Ksyear/FIRE-TAG/docs/BATTERY_PULL_TRIGGER.md

# 배터리–LOLIN D32 당김식 전원 연결

확인일: 2026-11-09. 기존 구매 목록의 **DTP652533 3.7 V 500 mAh 배터리**를 유지하는 기준입니다. 실물 제작·구동 시험은 아직 하지 않았습니다.

## 구현 방식

**분리핀을 당겨 빼면 전원이 켜지고, 핀이 빠진 동안 켜진 상태를 유지하는 구조**로 만들 수 있습니다. 전선을 당기는 대신 별도 핀·줄과 스위치 고정물을 사용합니다. 완제품 당김 스위치를 그대로 꽂는 구성은 아닙니다.

레버 마이크로스위치의 COM–NC 접점을 사용합니다.

| 상태 | 기구 동작 | COM–NC | 배터리 전원 |
| --- | --- | --- | --- |
| 핀 삽입 | 핀이 레버를 누른 상태 유지 | 열림 | OFF |
| 핀을 당겨 제거 | 레버가 원위치로 복귀 | 닫힘 | ON 유지 |
| 핀 재삽입 | 레버를 다시 누름 | 열림 | OFF |

이 동작은 회로·기구 구성 제안입니다. 핀 고정력, 당김 힘, 충격에 의한 오작동 여부는 고정물 제작 후 시험해야 합니다.

핀 삽입 OFF·제거 ON 유지의 배터리 트리거 구상

그림은 COM–NC 접점을 이용하는 기구 설명입니다. 실제 제작 사진·완제품 트리거·동작 검증 결과가 아닙니다.

## 구매 목록 — 디바이스마트

가격은 2026-11-09 실제 상품 페이지의 VAT 포함 표시가입니다. 검색 요약의 과거 가격과 다를 수 있으며 주문 시 재확인합니다.

| 부품 | 구매 수량 | 표시가 | 역할·준비기간 |
| --- | --- | --- | --- |
| [OMRON D2F-L-D](https://www.devicemart.co.kr/goods/view?no=8906172) | 1개 | 4,708원 | 레버형 SPDT, 납땜 단자. COM–NC 사용 / 4~5일 |
| [Molex 53047-0210](https://www.devicemart.co.kr/goods/view?no=14557287) | 최소 10개 주문, 실제 사용 1개 | 264원/개, 10개 2,640원 | 배터리의 51021-0200과 결합하는 1.25 mm 2핀 헤더 / 해외 1주일 |
| [NW3-CCA-160](https://www.devicemart.co.kr/goods/view?no=1327035) | 1개 | 198원 | D32 쪽 PH 대응 2.0 mm 2핀 케이블, 20 cm |
| [수축튜브 2파이 검정 1 m](https://www.devicemart.co.kr/goods/view?no=12772) | 1개 | 154원 | 납땜 접합부 개별 절연 |

위 전기 부품 표시가 합계 **7,700원**, 배송비·핀·줄·고정물 제작비 별도입니다. Molex 부품은 케이블이 없는 기판용 헤더이므로 배선 납땜과 흔들리지 않는 고정이 필요합니다.

추가 제작물: 스위치 고정 케이스, 레버를 눌러 유지하는 분리핀, 손잡이 줄, 전선 당김 방지 구조. 치수와 당김 힘을 확정하지 않아 특정 핀·줄 상품을 호환 확정품으로 지정하지 않았습니다.

이전에 안내한 [ada-4720 케이블 세트](https://www.devicemart.co.kr/goods/view?no=15530981)는 이번 확인에서 품절로 표시됐습니다. 이번 목록은 그 부품 대신 53047-0210 헤더를 사용하는 안입니다.

## 스위치·분리핀 확대 구상

스위치 트리거 구상도: 핀 삽입 OFF, 당겨 빼면 ON 유지

이 그림은 레버 작동 원리를 설명합니다. 실제 제품 단자 위치나 고정물 제작 치수를 뜻하지 않습니다.

## 전기 연결

```text
배터리 + → Molex 헤더 → 스위치 COM
스위치 NC → PH 2.0 케이블 + → D32 BAT+
배터리 − → PH 2.0 케이블 − → D32 GND
스위치 NO는 연결하지 않음
```

단자 위치를 모양·선 색만으로 정하지 않고 스위치 도면·기판 표기와 멀티미터로 확인합니다. 스위치를 배터리 양단에 병렬로 연결하면 단락되므로 위와 같이 +선에 직렬로 넣습니다. 배터리 선 자체를 자를 필요는 없습니다.

## 확인한 사양과 남은 시험

- LOLIN D32 공식 사양: 3.7 V Li-Po, PH-2 2.0 mm 배터리 단자, 최대 충전 전류 500 mA. [WEMOS 사양](https://docs.wemos.cc/en/latest/d32/d32.html)
- D2F-L-D는 D2F 일반 작동력 계열의 레버·납땜 단자형입니다. 제조사 표의 해당 계열 DC 저항 부하 정격은 **30 VDC, 2 A**입니다. `D2F-F` 저작동력형이나 `D2F-01` 미소부하형과 정격을 혼동하지 않습니다. [OMRON D2F 데이터시트](https://omronfs.omron.com/en_US/ecb/products/pdf/en-d2f.pdf)
- D2F 일반형의 최소 적용 부하는 제조사 표에서 5 VDC·100 mA의 참고값으로 제시됩니다. 배터리 전압에서 실제 Tag 부하·접점 저항·전압 강하·반복 동작을 확인해야 합니다. 이번 검토는 실물 연결 성공이나 장기 신뢰성을 보증하지 않습니다.
- 배터리 51021 계열과 53047 계열의 결합 관계: [Molex 규격](https://www.molex.com/content/dam/molex/molex-dot-com/products/automated/en-us/productspecificationpdf/510/51021/510211010-PS-000.pdf)
- 해당 배터리의 허용 충전 전류·보호회로는 추가 확인이 필요합니다. 충전 호환성이 확인되기 전에는 D32에 연결한 채 USB 충전을 진행하지 않습니다.
- USB가 꽂혀 있으면 스위치를 OFF해도 D32가 USB 전원으로 계속 동작할 수 있습니다. 배터리 트리거 시험은 USB를 분리한 상태에서 확인합니다.

제작 후 확인 순서: 배터리 분리 상태에서 COM–NC 도통 확인 → 극성 확인 → USB 분리 → 핀 삽입 OFF·제거 ON 확인 → 실제 UWB 측정 중 전압 강하·재부팅 여부 확인 → 반복 당김·당김 방지 구조 확인.
