Ksyear/FIRE-TAG/docs/images/스위치_트리거_생성기록.md

# 스위치 트리거 확대 구상도 생성 기록

- 생성 방식: 내장 image_gen 이미지 편집
- 기준 이미지: 당김식_배터리트리거_구상.png
- 출력 이미지: 스위치_트리거_구상도.png
- 목적: 배터리·보드 전체 배선보다 분리핀과 레버 스위치의 작동 구조를 크게 설명.
- 동작: 핀 삽입으로 레버를 누르면 COM–NC가 열려 OFF, 핀 제거로 레버가 복귀하면 COM–NC가 닫혀 ON 유지.
- 설명용 기구 구상이며 실물 동작·고정력·내구성·정확한 단자 위치는 검증하지 않았습니다.

## 최종 생성 프롬프트

Edit the referenced image into a NEW, MUCH MORE FOCUSED switch-trigger concept drawing. The user explicitly wants the SWITCH AND PULL-PIN MECHANISM, not another system overview or document link. Keep the clean navy Korean presentation style, but REMOVE the large battery and LOLIN board pictures and enlarge the switch assembly to dominate the image. One 16:9 landscape canvas, two clear side-by-side CLOSE-UP cutaway views of the SAME proposed trigger housing.

Title exactly: '스위치 트리거 구상도'.

LEFT: heading '① 핀 삽입 · OFF'. Show a small rigid protective housing containing a lever microswitch, with an electrically insulating white plastic pin inserted from above through a guide. A yellow pull ring is attached to the pin. The inserted pin mechanically holds the silver switch lever DOWN. Label the three visible mechanical parts with concise callouts: '분리핀', '레버', '마이크로스위치'. A small readable text under the view says '레버 눌림 → COM–NC 열림 → 전원 OFF'.

RIGHT: heading '② 당겨 빼기 · ON 유지'. Show exactly the same housing and switch, but with the pin pulled completely upward and out, a bold upward arrow next to the ring labelled '당김'. The spring-loaded lever has returned UP, so COM–NC is closed. Under this view text exactly '레버 복귀 → COM–NC 연결 → 전원 ON'. A short second line says '핀이 빠진 동안 ON 유지'.

For each switch show only two SYMBOLIC external terminal labels COM and NC, with red positive wire entering COM from the left and leaving NC to the right. Labels at the far wire ends may read '배터리 +' and 'LOLIN BAT+'; do not draw whole battery or board. Do not draw a wire that directly bypasses the COM–NC switch, and never connect positive to negative. This is a mechanical microswitch actuated by a removable pin, not a pin used as a bare electrical conductor or a shim inside a battery socket. The normal unpressed NC contact is closed; pressing the lever opens NC.

Use sparse clean technical illustration, white background, charcoal and navy labels, yellow ring, neutral gray housing, red positive lead. All Korean text must be large and legible. No dimensions, no exact commercial switch body or terminal-position claims, no relay, no MOSFET, no charger, no LED, no fire or explosive imagery. Small footer exactly '설명용 기구 구상 · 실물 동작 미검증'. This is a proposal for a pull-to-power-on mechanism, not a validated or manufactured product.
