Ksyear/FIRE-TAG/docs/images/당김식_배터리트리거_생성기록.md

# 당김식 배터리 트리거 이미지 생성 기록

- 방식: 내장 image_gen 생성 기능
- 이미지: 당김식_배터리트리거_구상.png
- 의미: 핀이 레버를 누르면 COM–NC 개방·OFF, 핀을 빼면 레버 복귀·COM–NC 연결·ON 유지.
- 범위: 배터리 +선에 스위치를 직렬로 넣는 제작 구상입니다. 실물 동작·접점 저항·당김 힘·내구성은 미검증입니다.
- 보드·소켓·기구 외형과 배선 위치는 설명용이며 실제 부품 조립 도면이 아닙니다.
- 근거: ../BATTERY_PULL_TRIGGER.md의 제조사 사양·배선 검토·디바이스마트 부품 목록.

## 최종 생성 프롬프트

Use case: scientific-educational. Generate ONE simple clean 16:9 landscape Korean illustration explaining a proposed pull-pin battery power trigger for a LOLIN D32 ESP32 prototype. White background, clear navy typography, friendly restrained product-diagram style consistent with an educational electronics presentation. Title exactly '당김식 배터리 전원 트리거 구상'. Two side-by-side panels showing THE SAME components in THE SAME arrangement. On the left of each panel a small flat silver/blue Li-Po pouch battery labelled '3.7V 배터리'. In the middle a small trigger housing with a CUTAWAY showing a lever microswitch and a removable NONCONDUCTIVE pin, the pin attached to a yellow pull ring or fabric pull tab. On the right a generic LOLIN D32 board labelled 'LOLIN D32'. A two-wire battery cable passes through this assembly to the board; red positive is switched, black negative runs directly and continuously to the board. All connector/socket depictions are symbolic, not assembly pin-position drawings.
LEFT PANEL title exactly '핀 삽입 · OFF'. Show pin inserted, mechanically HOLDING THE MICROSWITCH LEVER PRESSED DOWN. The COM–NC circuit is OPEN in this pressed condition, so the board is shown muted and a large neutral 'OFF' label. It is NOT a pin directly separating battery metal contacts.
RIGHT PANEL title exactly '핀 제거 · ON 유지'. Show the pin and yellow pull ring pulled completely out to the side, with a clear outward pull arrow labelled '당김'. The switch lever is now RELEASED, its COM–NC contact is CLOSED, battery power reaches the board, and the board is full color with a green 'ON' text label. The ON state persists while the pin remains absent; do not depict a button that must be held. Do not draw a glowing board LED or imply specific firmware behavior.
One short central caption exactly '배터리 +선에 스위치를 직렬 연결'. One small callout exactly '레버 스위치 COM–NC 사용'. Footer clearly reads '추가 제작 구상 · 실물 동작 미검증' and 'USB를 분리한 배터리 전원 기준'.
Keep schematic current paths physically sensible and NEVER bridge battery positive and negative. Do not add chargers, boost converters, relay modules, MOSFET boards, live flame, explosives, grenades, firefighter certification, human subjects, exact pin-number wiring, measured dimensions or charging claims. The intent is a readily understandable mechanical pull-trigger concept, not a finished commercial trigger or a photo of an assembled prototype.
