Ksyear/FIRE-TAG/발표자료/11/16/발표대본.md

# 11월 16일 발표 대본

- 범위: UWB·ESP32 통신 확인 이후 Pi 수신·좌표 저장·경량 UI까지
- 구성: 본편 10장 + 질문 대응용 부록 5장
- 시간: 본편 370초(6분 10초) 추정 + 전환·호흡 여유 50초 = 7분 기준. 실제 발화 리허설 전.
- 각 슬라이드의 동일 대본을 PPT 발표자 노트에도 저장
- [PPTX](FIRE-TAG_11월16일_발표자료_배터리추가.pptx) · [발표 흐름](발표흐름.md)

## 1. Pi 수신부터 경량 화면까지 연결 · 예상 30초

- 화면에서 짚을 곳: 지난 발표와 이번 발표의 범위 비교

지난 발표에서는 **UWB(유더블유비, 초광대역 무선)** 모듈을 **ESP32(이에스피삼십이)**에 연결하고 통신을 확인했습니다.
이번에는 앵커가 측정한 값을 **Raspberry Pi(라즈베리파이)**로 전달했습니다. Pi에 저장한 좌표를 경량 웹 화면에서 확인하는 단계까지 구성했습니다.
전체 연결 구조를 설명한 뒤 실제 코드와 동작 영상을 보여드리겠습니다.
(쉼)

- 근거: 경량버전/11월16일_발표자료.md, 1~4절

## 2. 실내 장치 구성 · 예상 35초

- 화면에서 짚을 곳: 아래 Tag, 양옆 앵커, 위쪽 A0와 Pi 순서

먼저 전체 장치 구성입니다.
이동하는 장치는 **Tag(태그)** 한 대입니다. 고정 장치는 **A0(에이제로)**, **A1(에이원)**, **A2(에이투)** 세 대입니다.
Tag와 앵커가 거리를 측정합니다. A0가 각 앵커의 보고를 모아 Pi로 전달합니다.
그림은 연결 관계를 설명하기 위한 예시입니다. 실제 위치 계산에는 시험 전에 교정한 앵커 좌표를 사용했습니다.
(쉼)

- 근거: firmware/fire_tag_tag/fire_tag_tag.ino:1, firmware/fire_tag_anchor/fire_tag_anchor.ino:1

## 3. Pi와 A0 연결 · 예상 30초

- 화면에서 짚을 곳: Pi와 A0 사이의 하늘색 USB 케이블

이제 중앙의 유선 연결부터 보겠습니다.
Pi의 **USB(유에스비)** 포트와 A0 ESP32를 케이블로 연결했습니다. 이때 A0가 **USB 시리얼(시리얼 통신)**로 측정 보고를 보냅니다.
A1과 A2의 보고도 A0를 거쳐 이 연결로 들어옵니다. 그래서 Pi에서는 A0에 연결된 시리얼 포트를 읽도록 구성했습니다.
다음은 거리값을 얻는 과정입니다.
(쉼)

- 근거: firmware/fire_tag_anchor/fire_tag_anchor.ino:3, raspberrypi/fire_tag_receiver.py:246

## 4. Tag와 앵커 거리 측정 · 예상 35초

- 화면에서 짚을 곳: Tag와 세 앵커 사이의 양방향 UWB 화살표

유선 연결에 앞서, 거리값은 여기서 만들어집니다.
Tag가 앵커에 요청을 보냅니다. 앵커가 응답하면 Tag가 마지막 메시지를 보냅니다.
그림의 **POLL(폴)**, **RESP(알이에스피)**, **FINAL(파이널)** 순서입니다. 앵커는 이 교환에서 얻은 시간 정보로 거리를 계산합니다.
Tag가 세 앵커와 이 과정을 반복합니다. 각 앵커까지의 거리값을 모아 다음 단계로 전달합니다.
(쉼)

- 근거: firmware/fire_tag_tag/fire_tag_tag.ino:3, firmware/fire_tag_anchor/fire_tag_anchor.ino:3

## 5. A1·A2 보고를 A0로 전달 · 예상 35초

- 화면에서 짚을 곳: A1·A2에서 A0로 들어오는 점선 화살표

측정한 거리값은 A0에 모읍니다.
A1과 A2는 **ESP-NOW(이에스피나우)**로 A0에 측정 보고를 보냅니다. A0는 자신의 측정값도 함께 모읍니다.
여기서 UWB는 거리 측정에 쓰고, ESP-NOW는 앵커 사이의 보고 전달에 씁니다.
Pi가 ESP-NOW 보고를 직접 받는 구조는 아닙니다. Pi에는 A0가 USB로 전달합니다.
(쉼)

- 근거: firmware/fire_tag_anchor/fire_tag_anchor.ino:3~7

## 6. Pi에서 위치 계산·화면 표시 · 예상 35초

- 화면에서 짚을 곳: USB 보고 방향과 하단 처리 순서

A0가 보낸 보고를 Pi에서 처리합니다.
수신기는 교정된 앵커 좌표와 Tag 거리값으로 평면 위치를 계산합니다. 계산한 좌표는 **SQLite(에스큐엘라이트)** 데이터베이스에 저장합니다.
경량 웹 서버는 저장된 값을 읽어서 화면에 제공합니다. 같은 **Wi-Fi(와이파이)**의 Mac이나 휴대폰에서 Pi에 접속합니다.
다음 화면에서는 이 처리 중 계산과 저장 부분을 실제 코드로 보겠습니다.
(쉼)

- 근거: raspberrypi/fire_tag_receiver.py:443, raspberrypi/fire_tag_web_lite.py:1

## 7. 거리값을 좌표로 계산해 저장 · 예상 45초

- 화면에서 짚을 곳: solve_position 호출, 실패 시 return, self.store.position 호출

앞에서 설명한 계산과 저장을 담당하는 코드입니다.
먼저 위쪽의 **solve_position(솔브 포지션)**을 보시면, 앵커 좌표와 거리값을 넣어 위치를 구합니다. 계산할 수 없으면 여기서 처리를 멈춥니다.
계산이 끝나면 **x, y(엑스, 와이)** 좌표를 얻습니다. 아래의 **store.position(스토어 포지션)**이 결과를 데이터베이스에 저장합니다.
그 전에 세 앵커의 거리 수집과 교정 완료를 검사합니다. 화면에는 핵심 부분만 발췌했습니다.
(쉼)

- 근거: raspberrypi/fire_tag_receiver.py:443~476, Store.position:114~119

## 8. 경량 화면에 저장 좌표를 표시 · 예상 35초

- 화면에서 짚을 곳: Tag 위치 점, 앵커 상태, 최근 이벤트

이어서 실제 Pi에서 제공한 경량 화면입니다.
제공받은 ZIP의 경량 UI 원본을 적용했습니다. 화면에서는 Tag의 마지막 저장 위치를 점으로 보여줍니다.
오른쪽에서는 앵커 상태와 최근 이벤트 **10개**를 확인합니다. 새 좌표가 들어오면 위치 점이 갱신됩니다.
이번 발표는 이 경량 화면까지입니다. 이어서 실제 접속 영상을 보여드리겠습니다.
(쉼)

- 근거: raspberrypi/web/index_lite.html:129, raspberrypi/fire_tag_web_lite.py:21, 이미지 저장/08_Pi_경량UI_실제화면.png

## 9. 실제 Pi에서 좌표 갱신을 확인 · 예상 55초

- 화면에서 짚을 곳: 영상 재생 후 Tag 점의 갱신

실제 Pi에 접속해 녹화한 영상입니다.
위치 점이 갱신되는 모습을 보시겠습니다.

[영상 **41.56초** 재생. 재생 중에는 설명을 멈춥니다.]

(쉼)

- 근거: 경량버전/Pi_경량UI_실제접속시험.mp4, 경량버전/11월16일_발표자료.md:4~5절

## 10. 통신·저장·화면 갱신을 확인 · 예상 35초

- 화면에서 짚을 곳: 이번 확인 결과와 남은 시험

여기까지 이번에 확인한 결과입니다.
세 앵커의 거리값을 Pi로 전달하고, 계산한 좌표를 저장해 경량 화면에서 갱신하는 흐름을 확인했습니다.
시험할 때마다 앵커 번호와 고정 배치, 앵커 세 쌍의 거리를 확인해야 합니다. 앵커를 옮기면 다시 교정합니다.
실제 기준 위치와 비교한 오차나 사람에게 가려지는 조건은 추가 시험이 필요합니다. 화재 현장 신뢰성도 아직 검증하지 않았습니다.
(쉼)

- 근거: 경량버전/11월16일_발표자료.md:4~5절

## 11. 시험 시작마다 앵커를 다시 교정 (선택 부록) · 예상 40초

- 화면에서 짚을 곳: config.update의 교정 플래그와 세 쌍 거리 표

앵커 배치가 바뀌는 경우의 처리입니다.
실행 스크립트가 시작할 때마다 자동 교정 플래그를 켭니다. A0·A1·A2의 세 쌍 거리를 모아 좌표를 다시 정하도록 했습니다.
마지막 시험에서는 세 쌍의 교정을 완료했습니다. 실행 도중 앵커를 옮기면 다시 시작해 재교정해야 합니다.
(쉼)

- 근거: raspberrypi/run_dev.sh:28~37, raspberrypi/anchor_pair_calibration.py:37~67, 경량버전/11월16일_발표자료.md:5절

## 12. 배터리 전원 연결 구상 (선택 부록) · 예상 40초

- 화면에서 짚을 곳: 배터리 양극의 직렬 스위치와 음극 직결 경로

이제 다음 제작 단계인 배터리 연결 계획입니다.
기존 선정 배터리는 **3.7V, 500mAh** 제품입니다. 배터리의 플러스 선에 스위치를 직렬로 넣고, 마이너스 선은 보드의 배터리 단자에 연결할 계획입니다.
분리핀을 당기면 전원이 켜지는 구조로 구상했습니다. 배터리 커넥터가 보드와 달라 변환 케이블도 제작해야 합니다.
현재는 연결 구상이며 실물 제작과 구동 시험 전입니다.
(쉼)

- 근거: 트리거_구상/BATTERY_PULL_TRIGGER.md; https://www.devicemart.co.kr/goods/view?no=15337888; https://docs.wemos.cc/en/latest/d32/d32.html

## 13. 커넥터 변환 케이블을 제작할 계획 (선택 부록) · 예상 50초

- 화면에서 짚을 곳: 1.25mm와 2.0mm 규격 차이, 네 가지 준비 부품

커넥터가 달라 그대로 꽂을 수는 없습니다.
기존 배터리는 **Molex(몰렉스) 51021-0200, 1.25mm** 커넥터이고, **LOLIN D32(로린 디삼십이)**는 **PH-2, 2.0mm** 배터리 단자입니다.
배터리 쪽에는 대응 헤더를 쓰고, 보드 쪽에는 PH 케이블을 연결할 계획입니다. 스위치와 절연 재료도 준비합니다.
표의 부품은 제작 후보입니다. 케이블 외형·극성을 확인하고, 스위치는 실제 배터리 부하에서 접점 동작을 시험한 뒤 확정하겠습니다.
(쉼)

- 근거: https://docs.wemos.cc/en/latest/d32/d32.html; https://www.devicemart.co.kr/goods/view?no=15337888; https://www.molex.com/content/dam/molex/molex-dot-com/products/automated/en-us/productspecificationpdf/510/51021/510211010-PS-000.pdf; https://omronfs.omron.com/en_US/ecb/products/pdf/en-d2f.pdf; 트리거_구상/BATTERY_PULL_TRIGGER.md. NW3-CCA-160은 A2001-02Y 하네스이며 제조사별 외형 변경 안내가 있어 D32 결합 확인 전에는 호환 확정품으로 표시하지 않음.

## 14. 당김식 전원 스위치 구상 (선택 부록) · 예상 30초

- 화면에서 짚을 곳: 핀 삽입 OFF, 핀 제거 ON 유지

분리핀의 동작은 이 그림과 같습니다.
절연핀이 레버를 누를 때는 **COM–NC(콤, 엔씨)** 접점이 열려 전원이 꺼집니다. 핀을 빼면 레버가 복귀하고 접점이 연결돼 켜진 상태를 유지합니다.
전선을 당기지 않고 별도 핀과 고정물을 당기는 방식으로 제작할 계획입니다.
실물 동작은 아직 검증하지 않았습니다.
(쉼)

- 근거: 트리거_구상/BATTERY_PULL_TRIGGER.md; https://omronfs.omron.com/en_US/ecb/products/pdf/en-d2f.pdf

## 15. 제작 후 전원 동작을 확인 (선택 부록) · 예상 45초

- 화면에서 짚을 곳: 분리 상태 검사, USB 분리 전원 시험, UWB 동작 시험

제작 후에는 이 순서로 확인하겠습니다.
먼저 배터리를 분리한 상태에서 극성과 스위치 도통을 확인합니다. 다음으로 USB를 빼고 핀 삽입과 제거에 따라 전원이 꺼지고 켜지는지 확인합니다.
이후 실제 UWB 동작 중 전압 강하나 재부팅, 반복 당김 시 접점 이상을 시험할 계획입니다.
배터리의 허용 충전 전류와 보호회로도 먼저 확인해야 합니다. 사용 시간은 소비전류를 측정한 뒤 산정하겠습니다.
(쉼)

- 근거: https://docs.wemos.cc/en/latest/d32/d32.html; https://omronfs.omron.com/en_US/ecb/products/pdf/en-d2f.pdf; 트리거_구상/BATTERY_PULL_TRIGGER.md. 아직 배터리 허용 충전 전류·보호회로·실제 부하 전류·동작 시간 미확인.
