Ksyear/FIRE-TAG/발표자료/11/16/경량버전/11월16일_발표자료.md

# 11월 16일 발표 자료 — FIRE-TAG 경량 UI

작성·시험일: 2026-11-09. 이번 발표는 ESP32·UWB 통신 확인 이후 **Raspberry Pi 수신과 경량 UI 구성까지** 다룹니다.

## 1. 지난 발표와 이번 발표

| 구분 | 발표 내용 |
| --- | --- |
| 지난 발표 | UWB 모듈을 ESP32에 연결하고 통신되는지 확인 |
| 이번 발표 | 앵커 데이터를 Pi로 전달하고, 앵커 상태·저장 좌표·최근 이벤트를 경량 웹 화면에 표시 |

이번 자료에는 기존 전체 UI의 동선·경보·명령 버튼이나 층별 확장 계획을 발표 기능으로 포함하지 않습니다.

## 2. 사용 장치와 데이터 흐름

- 요구조자 Tag: LOLIN D32 + DWM3000EVB, 1개
- 고정 앵커: ESP32 DevKitC + DWM3000EVB, 3개
- 수신·저장·웹 표시: Raspberry Pi

```text
Tag ↔ 앵커 A0·A1·A2             UWB 거리 측정
A1·A2 → A0                    ESP-NOW 데이터 전달
A0 → Raspberry Pi             USB 시리얼
Pi 수신기 → SQLite → 웹 화면   데이터 저장·표시
휴대폰·Mac → Pi                같은 Wi-Fi에서 HTTP 접속
```

단계별 발표에는 [4단계 설명 이미지와 발표 문장](단계별_설명자료.md)을 사용합니다.

### 실내 구성 설명 이미지

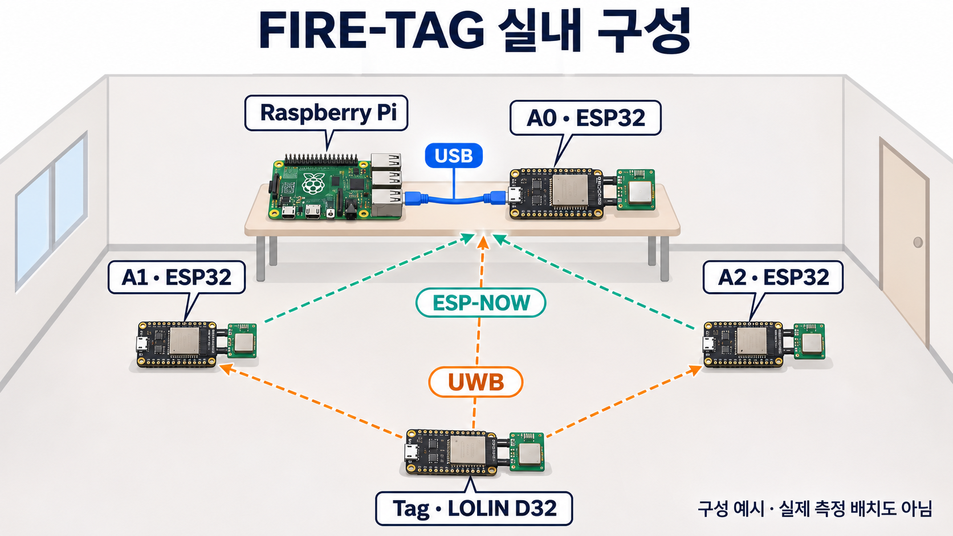
[picture p3: 발표자료/11/16/경량버전/images/실내_구성도.png]
중앙 Pi·A0와 양옆 A1·A2 구성


중앙의 라즈베리파이는 A0 ESP32와 USB로 연결합니다. 양옆 A1·A2 ESP32는 A0로 ESP-NOW 보고를 보내고, Tag와 세 앵커는 UWB로 거리를 측정합니다.

그림은 배치를 이해하기 위한 생성 이미지입니다. 실제 교실 사진이나 실측 배치도가 아니며, 마지막 시험에서 측정한 거리와 교정 결과는 아래 5절을 기준으로 설명합니다.

## 3. 경량 화면에 남긴 기능

- 평면도에 앵커 위치와 Tag의 마지막 저장 좌표 표시
- Tag 좌표가 갱신되면 점 위치 갱신, 동선은 표시하지 않음
- 앵커 상태: 작동 중 / 수신 기록 없음 / 응답 없음
- 최근 이벤트 10개
- Tag 데이터가 오래되면 `끊김`, 웹 API 접속이 실패하면 `Pi 연결 끊김` 표시
- 외부 CDN·인터넷 자료를 가져오지 않는 화면

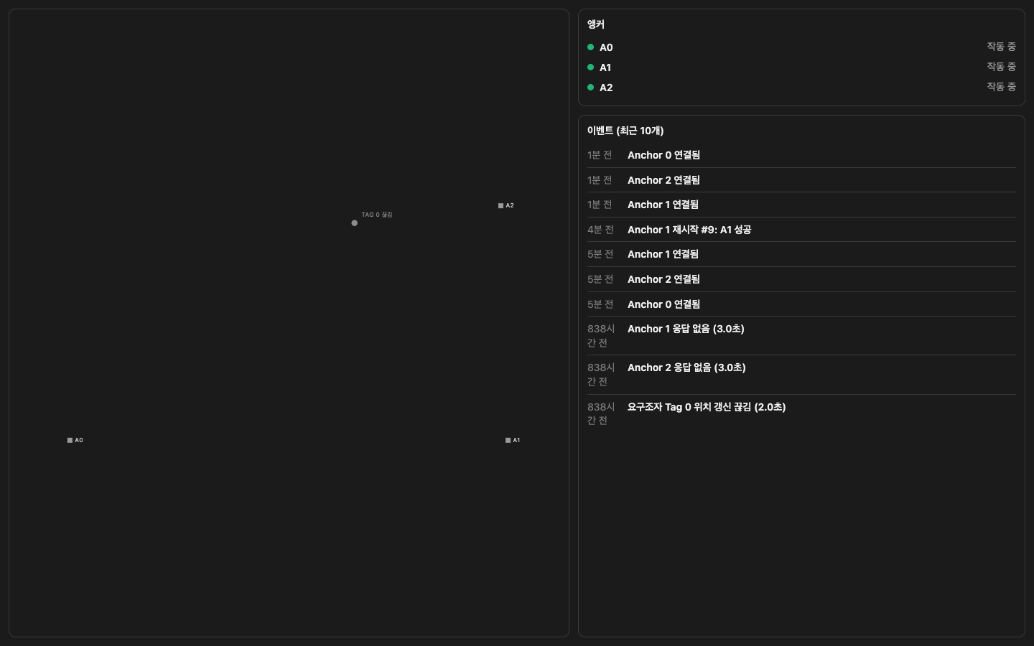
[picture p4: 발표자료/11/16/경량버전/Pi_경량UI_실제화면.png]
Pi에서 실제 제공한 경량 화면


화면은 ZIP 원본 서버·HTML을 그대로 사용해 실제 Pi에 접속한 캡처입니다. 앵커 세 쌍의 교정을 완료한 뒤 Tag의 새 좌표가 갱신되는 상태를 녹화했습니다.

## 4. 이번 시험에서 확인한 내용

| 시험 | 확인 결과 |
| --- | --- |
| Tag ↔ 앵커 | Tag 재시작 후 A0·A1·A2 거리 응답 로그 확인 |
| 앵커 → Pi | A0 재시작 후 세 앵커의 새 상태 데이터 수신 확인 |
| Pi 웹 서버 | Mac에서 HTML과 API 접속 확인 |
| 실제 화면 녹화 | 41.56초 녹화, API 응답 74회 모두 HTTP 200, 브라우저 스크립트 오류 0건, 서로 다른 좌표 71개 확인 |
| 경량 UI 기능 시험 | 별도 시험 DB로 점 이동·오래된 Tag 표시·이벤트 10개·연결 실패와 복구 확인 |
| 기존 코드 회귀 시험 | Python 자동 시험 15개 통과 |
| Wi-Fi 설정 | Mobile_504 유지, Hanbat_506 추가 등록. Hanbat_506 실제 접속 시험은 보류 |

UI 기능 시험의 좌표는 시험용 데이터입니다. 실제 UWB 측정 영상과 혼동하지 않습니다.

## 5. 앵커 재배치와 실제 위치 갱신

초기 배치에서는 A0–A1 직접 거리 보고가 없어 좌표 교정이 완료되지 않았습니다. 사용자가 가림막과 A1 배치를 확인한 뒤 측정을 새로 시작해 세 쌍의 교정이 완료됐습니다. 배치 확인 전후 관측 결과이며 특정 가림막만을 원인으로 확정한 것은 아닙니다.

| 측정 쌍 | 새 교정 거리 |
| --- | --- |
| A0–A1 | 6.89 m |
| A0–A2 | 6.57 m |
| A1–A2 | 3.47 m |

교정에 사용한 샘플은 89개이고, 표시된 반복 측정 산포는 약 8 cm입니다. 이 산포는 실제 위치 오차가 아닙니다. 교정 후 Tag의 새 좌표가 갱신되는 화면을 실제 Pi에서 녹화했습니다.

시험 실행 스크립트는 시작할 때마다 세 앵커의 상호 거리를 다시 확인하도록 수정했습니다. A1·A2의 배치가 바뀌어도 이전 좌표를 그대로 사용하지 않습니다. 실행 중 앵커를 옮긴 경우에는 다시 시작해 재교정해야 합니다.

실제 기준 위치와 비교한 정확도, 화재 현장 신뢰성은 이번 시험에서 검증하지 않았습니다.

## 6. 시연 자료와 접속

- [실제 Pi 대시보드 접속 시험 영상](Pi_경량UI_실제접속시험.mp4)
- 현재 경량 화면: `http://192.168.68.102:8080/`
- 네트워크를 바꾸면 Pi에서 `hostname -I`로 새 주소 확인
- 발표 전 매번 앵커 번호·고정 배치·세 쌍의 상호 거리를 확인하고 교정 완료 여부 확인

ZIP의 서버와 HTML을 수정 없이 사용합니다. 기존 화면은 별도 파일과 8081 포트로 보존했습니다. 이번 발표는 8080 포트의 경량 화면을 사용합니다.

## 발표 설명 예시

지난 발표에서는 UWB 모듈과 ESP32를 연결해 통신되는지 확인했습니다. 이번에는 앵커에서 받은 데이터를 Raspberry Pi에 저장하고 웹 화면으로 보여주는 단계까지 진행했습니다. 화면은 위치 점, 앵커 상태, 최근 이벤트만 남긴 경량 버전입니다. 시험 전에는 앵커 세 쌍의 거리를 직접 측정해 좌표를 새로 설정했고, 실제 Pi 화면에서 Tag 위치가 갱신되는 모습을 녹화했습니다. 앵커를 옮기면 다시 교정해야 합니다. 현재 확인한 결과는 실내 시제품의 통신·저장·위치 표시 동작이며 실제 위치 정확도까지 검증한 것은 아닙니다.
