Ksyear/FIRE-TAG/발표자료/11/16/경량버전/images/생성_기록.md

# 실내 구성도 생성 기록

- 생성 방식: 내장 image_gen 기능. CLI/API 키 방식은 사용하지 않았습니다.
- 파일: `실내_구성도.png`
- 구성: 중앙 Raspberry Pi+A0, 양옆 A1·A2, 앞쪽 Tag.
- 통신: Pi–A0 USB, A1·A2→A0 ESP-NOW, Tag↔앵커 UWB.
- 표현 범위: 설명용 실내 예시입니다. 교실 사진·실측 배치도·정확한 부품 외형이나 핀 배치 도면이 아닙니다.
- 근거: 프로젝트 README, `firmware/libraries/FireTagUwb/src/FireTagUwb.h`, 2026-11-09 실기 검증 기록.

## 최종 생성 프롬프트

Use case: infographic-diagram. Generate ONE simple, clean, landscape 16:9 educational illustration for a Korean FIRE-TAG university presentation. The user wants a quick understandable indoor arrangement, not a detailed engineering schematic. A plain classroom-like indoor room, lightly suggested neutral walls and floor, viewed from a clear slightly elevated isometric perspective. At the BACK CENTER of the room, on a small plain table, place a recognizable Raspberry Pi 4 and next to it an ESP32 DevKitC with a separate small UWB module. Label the Pi 'Raspberry Pi' and the ESP32 'A0 · ESP32'. Connect the Pi and A0 with ONE clearly visible short BLUE USB cable, label it 'USB'. A0 is the central gateway. On the LEFT SIDE of the room place a second ESP32 with a small UWB module, label 'A1 · ESP32'. On the RIGHT SIDE place a third ESP32 with a small UWB module, label 'A2 · ESP32'. A1 and A2 are a little forward of the central A0 so the three anchors form a visible triangle. Do NOT connect side boards to the Pi with wires. Draw a simple dashed teal wireless arrow from A1 toward A0 and another from A2 toward A0. A single common label says 'ESP-NOW'. In the foreground place one SMALL separate portable board icon labelled 'Tag · LOLIN D32' with a UWB module; draw three light orange dashed radio links to A0, A1 and A2, collectively labelled 'UWB'. Keep all radio lines thin and visually clear, no decorative waves. No people, flames, firefighters, clouds, routers, LoRa, battery circuits, distances, coordinate axes, pin tables, extra devices or screens. Title at the top exactly 'FIRE-TAG 실내 구성'. Large comfortably legible text, white or very light gray background, tidy spacing, subdued navy and teal colors, simple recognizable board illustrations. Small footer exactly '구성 예시 · 실제 측정 배치도 아님'. The central Pi connects ONLY to A0 through USB. A1/A2 report to A0 through ESP-NOW, while Tag ranges with the three anchors through UWB. Do not draw ESP32-to-router Wi-Fi connections. This is an explanatory generated illustration, not a photo of the actual test room.
