Ksyear/FIRE-TAG/발표자료/11/16/경량버전/images/단계별/생성_기록.md

# 단계별 이미지 생성 기록

- 방식: 내장 image_gen 편집 기능
- 기준 이미지: ../실내_구성도.png
- 네 장 모두 같은 구성 이미지에서 설명 경로만 강조했습니다.
- 설명용 이미지이며 실제 교실 사진·실측 배치도·부품 조립 도면이 아닙니다.

## 01_Pi_A0_USB_연결

Edit Image 1, the existing FIRE-TAG indoor diagram. This is an edit target, not just a style reference. Create ONE 16:9 landscape educational slide image for a four-step Korean presentation. Preserve the exact viewpoint, neutral room, table, board illustrations, board sizes and positions: Raspberry Pi back-center-left on table, A0 ESP32 immediately right of Pi on table, A1 on left side floor, A2 on right side floor, Tag at front center. Preserve readable device labels and the small footer '구성 예시 · 실제 측정 배치도 아님'. Use the same navy typography, orange UWB, teal ESP-NOW and blue USB as the base. Change ONLY the title and emphasis/communication arrows described for this step. Do not add people, devices, flame, batteries, routers, cloud, distance labels, a fake UI screenshot or new network technologies. No Wi-Fi radio links directly from ESP32 to Pi. Keep non-highlighted devices present in muted gray so the four images form a stable visual sequence. Make only the current step visually active and remove unrelated radio arrows, rather than showing every protocol in all four images. All text must be large and comfortably readable. STEP 1. Title exactly '1. Pi와 A0 연결'. Highlight the Raspberry Pi, the A0 ESP32 and their short blue USB cable at full color. Cable must plug into both existing boards. Keep side anchors and Tag muted but labelled. Remove ALL orange and teal radio arrows and their UWB/ESP-NOW badges. Add one short readable caption in empty center-floor space: 'Pi ↔ A0 · USB 시리얼'. Do not draw a direct GPIO connection or a cable from Pi to A1, A2 or Tag.

## 02_Tag_UWB_거리측정

Edit Image 1, the existing FIRE-TAG indoor diagram. This is an edit target, not just a style reference. Create ONE 16:9 landscape educational slide image for a four-step Korean presentation. Preserve the exact viewpoint, neutral room, table, board illustrations, board sizes and positions: Raspberry Pi back-center-left on table, A0 ESP32 immediately right of Pi on table, A1 on left side floor, A2 on right side floor, Tag at front center. Preserve readable device labels and the small footer '구성 예시 · 실제 측정 배치도 아님'. Use the same navy typography, orange UWB, teal ESP-NOW and blue USB as the base. Change ONLY the title and emphasis/communication arrows described for this step. Do not add people, devices, flame, batteries, routers, cloud, distance labels, a fake UI screenshot or new network technologies. No Wi-Fi radio links directly from ESP32 to Pi. Keep non-highlighted devices present in muted gray so the four images form a stable visual sequence. Make only the current step visually active and remove unrelated radio arrows, rather than showing every protocol in all four images. All text must be large and comfortably readable. STEP 2. Title exactly '2. Tag와 앵커 거리 측정'. Highlight Tag and all three anchors A0/A1/A2 at full color, and keep Pi and the USB cable muted. Draw THREE clear bidirectional orange radio arrows between Tag and A0, between Tag and A1, and between Tag and A2. Ensure each orange line terminates at the corresponding anchor board, especially A0 on the right side of the central table, never at the Raspberry Pi or at the USB cable. Remove ALL teal ESP-NOW arrows and labels. Use one orange 'UWB' badge and a concise explanatory caption 'POLL → RESP → FINAL'. This is two-way ranging; both ends of each orange link need arrowheads.

## 03_ESP_NOW_A0_보고전달

Edit Image 1, the existing FIRE-TAG indoor diagram. This is an edit target, not just a style reference. Create ONE 16:9 landscape educational slide image for a four-step Korean presentation. Preserve the exact viewpoint, neutral room, table, board illustrations, board sizes and positions: Raspberry Pi back-center-left on table, A0 ESP32 immediately right of Pi on table, A1 on left side floor, A2 on right side floor, Tag at front center. Preserve readable device labels and the small footer '구성 예시 · 실제 측정 배치도 아님'. Use the same navy typography, orange UWB, teal ESP-NOW and blue USB as the base. Change ONLY the title and emphasis/communication arrows described for this step. Do not add people, devices, flame, batteries, routers, cloud, distance labels, a fake UI screenshot or new network technologies. No Wi-Fi radio links directly from ESP32 to Pi. Keep non-highlighted devices present in muted gray so the four images form a stable visual sequence. Make only the current step visually active and remove unrelated radio arrows, rather than showing every protocol in all four images. All text must be large and comfortably readable. STEP 3. Title exactly '3. A1·A2 보고를 A0로 전달'. Highlight A1, A2 and A0, keep Pi and Tag muted. Draw TWO clear teal dashed arrows, one FROM A1 TO A0 and one FROM A2 TO A0. They must terminate precisely at the A0 ESP32 board immediately right of the Raspberry Pi, NOT at the Pi, not at the USB cable, and not in empty space under the table. Label the arrows 'ESP-NOW'. Remove ALL orange UWB arrows and badges. Keep the physical USB cable present but muted. Add short caption in empty floor area 'A0는 자신의 측정값도 함께 모음'. Do not draw wireless arrows between Pi and side anchors.

## 04_Pi_위치계산_화면표시

Edit Image 1, the existing FIRE-TAG indoor diagram. This is an edit target, not just a style reference. Create ONE 16:9 landscape educational slide image for a four-step Korean presentation. Preserve the exact viewpoint, neutral room, table, board illustrations, board sizes and positions: Raspberry Pi back-center-left on table, A0 ESP32 immediately right of Pi on table, A1 on left side floor, A2 on right side floor, Tag at front center. Preserve readable device labels and the small footer '구성 예시 · 실제 측정 배치도 아님'. Use the same navy typography, orange UWB, teal ESP-NOW and blue USB as the base. Change ONLY the title and emphasis/communication arrows described for this step. Do not add people, devices, flame, batteries, routers, cloud, distance labels, a fake UI screenshot or new network technologies. No Wi-Fi radio links directly from ESP32 to Pi. Keep non-highlighted devices present in muted gray so the four images form a stable visual sequence. Make only the current step visually active and remove unrelated radio arrows, rather than showing every protocol in all four images. All text must be large and comfortably readable. STEP 4. Title exactly '4. Pi에서 위치 계산·화면 표시'. Highlight A0 and Raspberry Pi and their blue USB cable. Add a clear small blue directional arrow above the cable FROM A0 on right TOWARD Pi on left, showing reports going to Pi. Keep A1, A2 and Tag muted with unchanged positions and labels. Remove ALL orange and teal radio arrows/badges. In empty center floor area, show ONE simple large horizontal text process: '수신 → 위치 계산 → SQLite 저장 → 경량 UI'. Below it add 'Mac·휴대폰에서 같은 Wi-Fi로 접속'. Do not draw an invented dashboard, browser screen, laptop, router, cloud or any extra hardware. This image introduces the real screenshot and real video shown separately in the next slides.
