Ksyear/FIRE-TAG/발표자료/11/16/README.md

# 11월 16일 발표 자료

이번 발표 범위는 **경량 UI 버전까지**입니다.

- [완성 PPTX · 본편 10장과 선택 부록 2장](FIRE-TAG_11월16일_발표자료.pptx)
- [PDF 백업본](FIRE-TAG_11월16일_발표자료.pdf)
- [슬라이드별 발표 대본](발표대본.md)
- [발표 흐름·시간·코드 설명·질문 대응](발표흐름.md)

- [경량 버전 발표 자료](경량버전/11월16일_발표자료.md)
- [실제 Pi 접속 시험 영상](경량버전/Pi_경량UI_실제접속시험.mp4)
- [실제 화면 캡처](이미지%20저장/08_Pi_경량UI_실제화면.png)

- [손그림 버전 이미지 폴더·목록](이미지%20저장/_이미지_목록.md)
- [손그림 변경 전 원래 버전 이미지 7장](이미지%20저장/원래버전/_이미지_목록.md)
- [실내 구성 이미지](이미지%20저장/01_실내_전체구성.png)
- [단계별 설명 이미지 4장과 발표 문장](경량버전/단계별_설명자료.md)
- [PPT 이미지·영상 삽입안](경량버전/PPT_이미지_삽입안.md)

- [스위치 트리거 구상도](이미지%20저장/07_스위치_트리거_구상도.png)
- [배터리 트리거 구상·구매 목록](트리거_구상/BATTERY_PULL_TRIGGER.md)

이미지는 모두 `이미지 저장/` 아래에 모았습니다. 현재 생성 이미지 7장은 아이보리 배경·검은 손글씨와 펜 선·하늘색 한 계열로 통일했고, 변경 전 원래 이미지 7장은 `원래버전/` 하위 폴더에 별도 보관했습니다. 실제 UI 캡처 1장은 원본을 유지하며 두 버전에서 공통으로 사용합니다. [최종 생성 프롬프트](이미지%20저장/이미지생성프롬프트_FIRE-TAG_11월16일.md)도 같은 폴더에 있습니다.

## 코드 버전 구분

| 버전 | 화면 파일 | 접속 경로 |
| --- | --- | --- |
| 경량·다운그레이드 | [index_lite.html](../../../raspberrypi/web/index_lite.html) | `:8080/` |
| 기존 전체 화면 | [index_full.html](../../../raspberrypi/web/index_full.html) | `:8081/` |

ZIP 원본 서버(`fire_tag_web_lite.py`)와 원본 HTML을 그대로 사용합니다. 수신기·SQLite는 두 버전이 공유하고 웹 서버·API는 분리합니다. 전체 화면의 경보·명령·CSV 기능은 기존 API로 유지되며 경량 화면에는 표시하지 않습니다.
