Ksyear/FIRE-TAG/발표자료/11/16/발표흐름.md

# 11월 16일 발표 흐름

- [완성 PPTX](FIRE-TAG_11월16일_발표자료_배터리추가.pptx) · [PDF 백업](FIRE-TAG_11월16일_발표자료_배터리추가.pdf) · [슬라이드별 발표 대본](발표대본.md)
- 본편 10장, 선택 부록 5장. 범위는 Pi 수신·좌표 저장·경량 UI까지.
- 발표 시간 미지정으로 7분 기준 구성. 본편 예상 370초(6분 10초), 나머지 50초는 전환·호흡 여유. 실제 리허설 실측값이 아님.
- 기본 그림은 손그림 버전 사용. [변경 전 이미지 7장](이미지%20저장/원래버전/_이미지_목록.md)은 별도 보관.

## 설명 순서

지난 발표의 통신 확인을 짧게 짚고, 이번에 연결한 Pi 수신·저장·화면 표시를 소개합니다. 전체 구성도를 먼저 보여준 뒤 USB 연결, UWB 거리 측정, ESP-NOW 보고, Pi 처리 순서로 설명합니다. 실제 코드 한 장과 실제 UI를 보여주고 녹화 영상을 재생합니다. 마지막 장에서 확인한 동작과 남은 시험을 구분합니다.

| 장 | 화면 | 누적 시간(추정) | 예상 체류 | 넣은 자료 |
| --- | --- | --- | --- | --- |
| 1 | Pi 수신부터 경량 화면까지 연결 | 0:00~0:30 | 30초 | 지난 발표와 이번 범위 비교 |
| 2 | 실내 장치 구성 | 0:30~1:05 | 35초 | [그림](%EC%9D%B4%EB%AF%B8%EC%A7%80%20%EC%A0%80%EC%9E%A5/01_%EC%8B%A4%EB%82%B4_%EC%A0%84%EC%B2%B4%EA%B5%AC%EC%84%B1.png) |
| 3 | Pi와 A0 연결 | 1:05~1:35 | 30초 | [그림](%EC%9D%B4%EB%AF%B8%EC%A7%80%20%EC%A0%80%EC%9E%A5/02_Pi_A0_USB_%EC%97%B0%EA%B2%B0.png) |
| 4 | Tag와 앵커 거리 측정 | 1:35~2:10 | 35초 | [그림](%EC%9D%B4%EB%AF%B8%EC%A7%80%20%EC%A0%80%EC%9E%A5/03_Tag_UWB_%EA%B1%B0%EB%A6%AC%EC%B8%A1%EC%A0%95.png) |
| 5 | A1·A2 보고를 A0로 전달 | 2:10~2:45 | 35초 | [그림](%EC%9D%B4%EB%AF%B8%EC%A7%80%20%EC%A0%80%EC%9E%A5/04_ESP_NOW_A0_%EB%B3%B4%EA%B3%A0%EC%A0%84%EB%8B%AC.png) |
| 6 | Pi에서 위치 계산·화면 표시 | 2:45~3:20 | 35초 | [그림](%EC%9D%B4%EB%AF%B8%EC%A7%80%20%EC%A0%80%EC%9E%A5/05_Pi_%EC%9C%84%EC%B9%98%EA%B3%84%EC%82%B0_%ED%99%94%EB%A9%B4%ED%91%9C%EC%8B%9C.png) |
| 7 | 거리값을 좌표로 계산해 저장 | 3:20~4:05 | 45초 | 실제 수신기 코드 발췌 |
| 8 | 경량 화면에 저장 좌표를 표시 | 4:05~4:40 | 35초 | [실제 UI 캡처](이미지%20저장/08_Pi_경량UI_실제화면.png) |
| 9 | 실제 Pi에서 좌표 갱신을 확인 | 4:40~5:35 | 55초 | [실제 영상](경량버전/Pi_경량UI_실제접속시험.mp4) |
| 10 | 통신·저장·화면 갱신을 확인 | 5:35~6:10 | 35초 | 확인 결과·다음 시험 |

## 코드 화면을 보여주는 방법

- 본편 7장에 실제 `fire_tag_receiver.py`의 `flush()` 일부만 표시. `solve_position`과 `self.store.position` 두 호출을 중심으로 설명.
- 코드는 편집 가능한 PPT 텍스트. 캡처 이미지로 만들지 않았고, 읽기 쉽게 줄바꿈과 생략 주석만 추가.
- 입력은 교정된 앵커 좌표와 앵커별 거리(m). 출력은 x·y 좌표와 DB의 최근 좌표 갱신.
- 코드 앞의 거리 개수 확인·앵커 교정 완료 검사, 중간 상태 갱신·로그는 발췌 화면에서 생략. 원본 실행 코드의 검사를 삭제한 것이 아님.
- `rms`는 거리 잔차이며 실제 기준 위치에 대한 위치 오차로 발표하지 않음.
- 전체 IDE, 긴 수식 구현, 경량 UI에 없는 명령·경보 코드는 본편에서 설명하지 않음.
- 부록 11장은 `run_dev.sh`의 매 시작 재교정 설정과 마지막 시험의 앵커 거리 표. 재배치 질문에 사용.

## 영상 시연 순서

1. 본편 8장에서 위치 점, 앵커 상태, 최근 이벤트 10개를 먼저 짚습니다.
2. 9장으로 넘겨 영상이 실제 Pi 접속 기록임을 한 문장으로 말합니다.
3. PPT에 포함한 영상을 클릭해 41.56초 재생합니다. 재생 중에는 점이 갱신되는 모습을 보게 둡니다.
4. 영상이 끝나면 잠시 멈추고 10장의 결과로 넘어갑니다.
5. 재생 문제가 있으면 [원본 MP4](경량버전/Pi_경량UI_실제접속시험.mp4)를 별도로 엽니다. PDF는 영상 재생용이 아닌 정지 화면 백업입니다.

실시간 Pi 접속을 필수 시연 경로로 잡지 않았습니다. 하드웨어를 함께 시연할 경우 발표 당일 같은 네트워크에서 Pi 주소와 서버 실행 상태를 확인해야 합니다. 시험 당시 주소를 현재 접속 가능한 주소로 보장하지 않습니다.

## 시험 전 확인할 것

- 매 시험마다 A0·A1·A2 번호, 고정 배치, 세 쌍 상호 거리를 확인합니다.
- A1·A2 위치가 바뀌면 새 배치에서 교정 완료 후 Tag 이동 시험을 시작합니다.
- 실행 중 앵커를 옮겼다면 재시작해 다시 교정합니다.
- 마지막 시험 기록: A0–A1 6.89 m, A0–A2 6.57 m, A1–A2 3.47 m, 교정 샘플 89개.
- 반복 측정 산포 약 8 cm는 실제 위치 정확도 8 cm를 뜻하지 않습니다.

## 선택 부록과 질문 대응

| 질문 | 답할 내용 | 근거·보조 화면 |
| --- | --- | --- |
| 지난 발표에서 무엇이 늘었나요? | 앵커 보고를 Pi에 수신해 좌표를 저장하고 경량 웹 화면에 표시하는 단계까지 연결했습니다. | 본편 1·6·7장 |
| Wi-Fi로 거리를 재나요? | Tag–앵커 거리는 UWB로 측정합니다. A1·A2 보고는 ESP-NOW로 A0에 전달하고, 브라우저의 Pi 웹 접속은 같은 Wi-Fi를 사용합니다. | 본편 2·4·5·6장 |
| 앵커를 옮기거나 A1·A2 배치가 바뀌면요? | 번호·배치와 세 쌍 거리를 다시 확인하고 재교정합니다. 실행 중 이동하면 재시작해야 합니다. | 부록 11장 |
| 화면 점이 실제 이동 경로와 얼마나 맞나요? | 새 저장 좌표의 갱신을 확인했습니다. 실제 기준 위치·경로와 비교한 정량 오차는 이번 시험에서 검증하지 않았습니다. | 본편 9·10장 |
| 경량 UI를 쓰면 위치 튐이 줄어드나요? | UI에 이동 경로선을 표시하지 않는 것과 측정 오차 감소는 별개입니다. 가림·배치 조건과 기준 위치 비교 시험이 필요합니다. | 본편 8·10장 |
| 사람에게 가리거나 화재 환경에서도 되나요? | 해당 조건의 신뢰성 시험은 아직 하지 않았습니다. 이번 실내 동작 확인만으로 사용 적합성을 보장할 수 없습니다. | 본편 10장 |
| 두 Wi-Fi 모두 시험했나요? | Pi에 두 프로필을 등록했습니다. Hanbat_506 실제 접속 시험은 보류 상태입니다. | 경량버전/11월16일_발표자료.md 4절 |
| 배터리 트리거도 만들었나요? | 추가 제작 구상이며 실물 제작·동작 시험 전입니다. 이번 경량 UI 구현 결과에 포함하지 않습니다. | 부록 12~15장 |

## 배터리 계획을 설명할 때

| 장 | 내용 | 예상 시간 |
| --- | --- | --- |
| 12 | 배터리 +선에 스위치를 직렬로 넣는 전체 연결 구상 | 40초 |
| 13 | 1.25 mm 배터리 커넥터와 D32의 PH-2·2.0 mm 차이, 부품 후보 | 50초 |
| 14 | 절연핀 삽입 OFF·제거 ON 유지의 레버 동작 | 30초 |
| 15 | 극성·도통 확인, USB 분리 전원 시험, UWB 동작 중 전압·재부팅 시험 | 45초 |

배터리 부록 네 장의 예상 합계는 165초(2분 45초)입니다. 본편 10장 뒤에 모두 설명하면 기본 분량 외에 이 시간이 추가됩니다. 짧게 소개할 때는 12장만 보여주고 13~15장은 질문 대응용으로 사용합니다. 모든 시간은 추정이며 실제 리허설 전입니다.

배터리 연결·스위치 고정물 제작·사용 시간 측정은 앞으로 할 일로 설명합니다. 충전 조건과 보호회로를 확인하기 전에는 충전 호환성을 확정하지 않습니다. 구체적인 부품 후보와 근거는 [배터리 연결 문서](트리거_구상/BATTERY_PULL_TRIGGER.md)에 있습니다.

## 준비 상태와 발표 당일 확인

- [x] 본편 10장에 대응하는 대본 10블록과 전환 멘트·쉼 표시 작성
- [x] 각 블록 예상 60초 이하. 영상 장표 55초에는 영상 41.56초 포함
- [x] 본편 예상 370초로 7분의 약 88% 구성
- [x] 실제 코드·구성 그림·실제 캡처·실제 영상의 역할 구분
- [x] 확인된 동작과 위치 정확도·가림 조건의 미검증 범위 구분
- [ ] 발표 PC의 글꼴 표시와 영상 재생 확인
- [ ] 타이머를 켜고 실제 발화 시간 측정
- [ ] 실제 리허설 뒤 장표별 시간 조정

현재 파일은 PPTX와 대본·흐름 문서입니다. 질문 대응용 부록 11~15장은 기본 발표 시간에 포함하지 않았습니다.
