Ksyear/FIRE-TAG/발표자료/11/16/경량버전/PPT_이미지_삽입안.md

# 11/16 PPT 이미지·영상 삽입안

발표 범위는 지난 UWB–ESP32 통신 확인 이후 Raspberry Pi 수신·저장과 경량 UI까지입니다. 기존 전체 UI·배터리 트리거·층별 확장을 이번 구현 결과에 넣지 않습니다.

완성 파일은 [PPTX](../FIRE-TAG_11월16일_발표자료_배터리추가.pptx)와 [PDF 백업](../FIRE-TAG_11월16일_발표자료_배터리추가.pdf)입니다. [발표 대본](../발표대본.md)은 발표자 노트에도 포함했고, [발표 흐름](../발표흐름.md)에 예상 시간·코드 설명·질문 대응을 정리했습니다.

## 슬라이드 구성

| 슬라이드 | 넣은 자료 | 설명 |
| --- | --- | --- |
| 1. Pi 수신부터 경량 화면까지 | 지난 발표·이번 발표 비교 | 통신 확인 이후 Pi 수신·저장·경량 UI까지 연결한 범위 |
| 2. 전체 구성 | [실내 구성도](../이미지%20저장/01_실내_전체구성.png) | Tag·앵커·Pi의 역할부터 소개 |
| 3. Pi와 A0 연결 | [USB 연결 그림](../이미지%20저장/02_Pi_A0_USB_연결.png) | Pi와 A0의 USB 시리얼 |
| 4. UWB 거리 측정 | [거리 측정 그림](../이미지%20저장/03_Tag_UWB_거리측정.png) | Tag와 세 앵커의 메시지 교환 |
| 5. A0로 보고 전달 | [ESP-NOW 그림](../이미지%20저장/04_ESP_NOW_A0_보고전달.png) | A1·A2 보고의 수신 지점은 A0 |
| 6. Pi 처리 | [위치 계산·표시 그림](../이미지%20저장/05_Pi_위치계산_화면표시.png) | 수신·위치 계산·SQLite 저장·경량 UI |
| 7. 실제 수신기 코드 | fire_tag_receiver.py flush() 발췌 | solve_position과 self.store.position 중심 |
| 8. 실제 경량 UI | [원본 화면 캡처](../이미지%20저장/08_Pi_경량UI_실제화면.png) | 위치 점·앵커 상태·최근 이벤트 10개 |
| 9. 실제 동작 영상 | [41.56초 MP4](Pi_경량UI_실제접속시험.mp4) | PPT에 실제 영상 파일 포함 |
| 10. 확인 결과·다음 시험 | 확인 동작·남은 시험 | 교정·새 좌표 갱신 확인, 기준 위치 오차·가림 조건 미검증 |
| 선택 부록 11. 매 시작 재교정 | run_dev.sh 코드·교정 거리 표 | 앵커 번호·배치·세 쌍 거리 매번 확인 |
| 선택 부록 12. 배터리 연결 | [전체 배터리 연결도](../이미지%20저장/06_당김식_배터리트리거_구상.png) | 배터리 +선 직렬 스위치, 실물 구동 전 |
| 선택 부록 13. 커넥터 변환 | 규격 차이·준비 부품 표 | 배터리 1.25 mm와 D32 PH-2·2.0 mm, 후보품은 호환 확인 후 선정 |
| 선택 부록 14. 전원 스위치 | [전원 스위치 확대도](../이미지%20저장/07_스위치_트리거_구상도.png) | 핀 삽입 OFF·제거 ON 유지 |
| 선택 부록 15. 제작 후 시험 | 검사 순서 | 극성·도통, USB 분리 전원 시험, UWB 구동 시험·충전 조건 확인 |

각 이미지의 발표 문장은 [단계별 설명 자료](단계별_설명자료.md)를 사용합니다. 네 장을 같은 크기·같은 위치로 배치하고 화면 전환은 단순 전환으로 맞춥니다. 생성 이미지는 아이보리 배경·검은 손글씨와 펜 선·하늘색 강조를 공통으로 사용하며, 모든 PNG는 [이미지 저장 폴더](../이미지%20저장/_이미지_목록.md)에 모았습니다.

## 구성도에서 설명할 순서

1. **중앙 Pi와 A0**: Pi의 USB 3.0 포트와 A0 ESP32를 USB 케이블로 연결합니다. Pi GPIO에 UWB를 직접 연결한 구조가 아닙니다.
2. **양옆 A1·A2**: ESP32+DWM3000EVB 앵커가 측정 보고를 ESP-NOW로 A0에 전달합니다.
3. **Tag와 세 앵커**: UWB로 거리를 측정합니다. 공유기 Wi-Fi로 Tag의 거리를 재는 방식이 아닙니다.
4. **Pi 내부 처리**: A0의 USB 시리얼을 읽어 위치를 계산하고 SQLite에 저장한 뒤 웹 화면에 표시합니다.
5. **화면 접속**: 같은 Wi-Fi의 Mac·휴대폰에서 Pi에 HTTP로 접속합니다.

그림 아래 넣을 짧은 설명:

> UWB로 거리 측정 → ESP-NOW로 A0에 보고 → USB로 Pi에 전달 → 경량 화면에 표시

## 그림의 사용 범위

- 구성도는 사용자가 요청한 단순한 실내 배치 예시입니다. 실제 교실 사진이나 실측 좌표 도면으로 소개하지 않습니다.
- A1·A2는 실제 배치가 달라질 수 있습니다. 마지막 시험의 교정 거리는 A0–A1 6.894 m, A0–A2 6.569 m, A1–A2 3.471 m입니다.
- 시험마다 앵커 번호·배치·상호 거리를 확인하고, 이동 후에는 다시 교정합니다.
- 교정의 반복 측정 산포 약 8 cm를 위치 정확도 8 cm라고 발표하지 않습니다.
- 프레젠테이션에서 실제 UI와 실제 영상은 원본 파일을 사용합니다. 그림 생성으로 시험 결과를 대신하지 않습니다.

## PPT 편집 시 확인

- 16:9 슬라이드에 그림 전체가 보이도록 삽입하고 비율을 잠급니다. 그림의 선이나 라벨이 잘리도록 채우기 자르기를 하지 않습니다.
- 생성 이미지에 제목이 있으므로 같은 제목을 슬라이드에 중복해서 넣지 않습니다.
- 영상은 `삽입 → 비디오 → 파일에서` 방식으로 넣고, 발표할 PC에서 오프라인 재생을 확인합니다.
- 본편은 10장, 선택 부록은 5장입니다. 본편 예상 6분 10초에 전환 여유 50초를 더한 7분 기준이며 실제 리허설은 아직 하지 않았습니다. 배터리 부록 12~15장을 모두 설명할 경우 예상 2분 45초가 추가됩니다.
