Ksyear/FIRE-TAG/발표자료/11/16/FIRE-TAG_11월16일_발표자료.pptx

FIRE-TAG

Pi 수신부터 경량 화면까지

지난 발표

UWB 모듈과 ESP32 통신 확인

앵커 보고 수신, 좌표 저장, 경량 UI

이번 발표

11월 16일 발표 · 시험 기록 2026.11.09

FIRE-TAG · 11/16

01 / 12

Notes: 슬라이드 1: Pi 수신부터 경량 화면까지 연결
본편. 예상 30초 (추정, 리허설 전)

[발표 대본]
지난 발표에서는 UWB(유더블유비, 초광대역 무선) 모듈을 ESP32(이에스피삼십이)에 연결하고 통신을 확인했습니다.
이번에는 앵커가 측정한 값을 Raspberry Pi(라즈베리파이)로 전달했습니다. Pi에 저장한 좌표를 경량 웹 화면에서 확인하는 단계까지 구성했습니다.
전체 연결 구조를 설명한 뒤 실제 코드와 동작 영상을 보여드리겠습니다.
(쉼)

[가리킬 곳]
지난 발표와 이번 발표의 범위 비교

[화면 핵심어]
UWB·ESP32 통신 확인 / Pi 수신·좌표 저장·경량 UI

[근거]
경량버전/11월16일_발표자료.md, 1~4절

## Slide 2


FIRE-TAG · 11/16

02 / 12

Notes: 슬라이드 2: 실내 장치 구성
본편. 예상 35초 (추정, 리허설 전)

[발표 대본]
먼저 전체 장치 구성입니다.
이동하는 장치는 Tag(태그) 한 대입니다. 고정 장치는 A0(에이제로), A1(에이원), A2(에이투) 세 대입니다.
Tag와 앵커가 거리를 측정합니다. A0가 각 앵커의 보고를 모아 Pi로 전달합니다.
그림은 연결 관계를 설명하기 위한 예시입니다. 실제 위치 계산에는 시험 전에 교정한 앵커 좌표를 사용했습니다.
(쉼)

[가리킬 곳]
아래 Tag, 양옆 앵커, 위쪽 A0와 Pi 순서

[화면 핵심어]
Tag 1대 / 앵커 3대 / A0 / Raspberry Pi

[근거]
firmware/fire_tag_tag/fire_tag_tag.ino:1, firmware/fire_tag_anchor/fire_tag_anchor.ino:1

## Slide 3

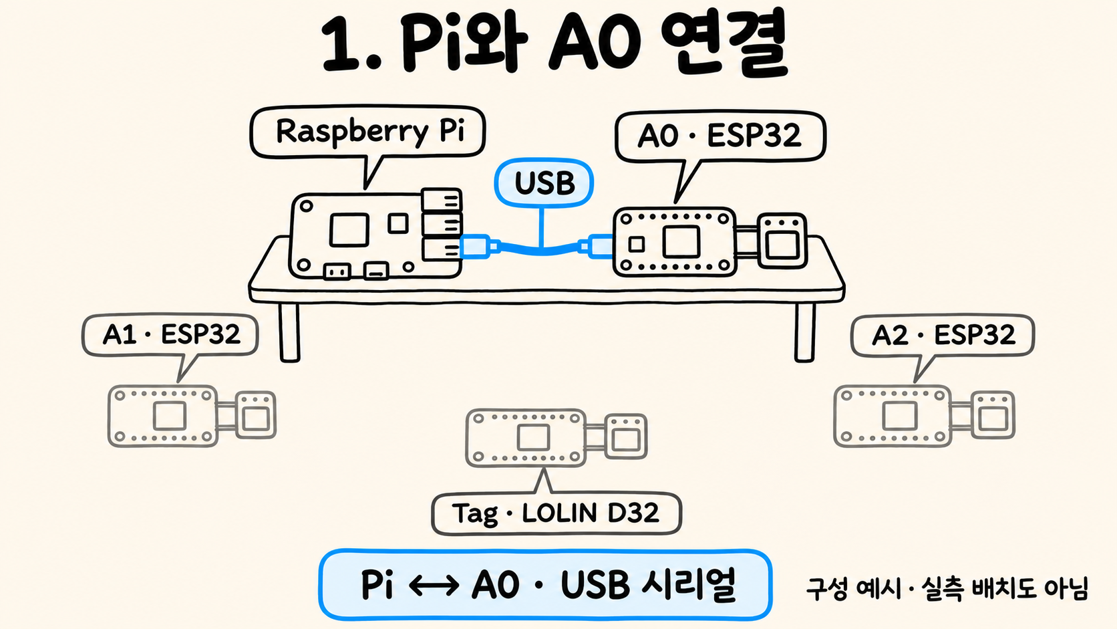
[picture p10: figure]

FIRE-TAG · 11/16

03 / 12

Notes: 슬라이드 3: Pi와 A0 연결
본편. 예상 30초 (추정, 리허설 전)

[발표 대본]
이제 중앙의 유선 연결부터 보겠습니다.
Pi의 USB(유에스비) 포트와 A0 ESP32를 케이블로 연결했습니다. 이때 A0가 USB 시리얼(시리얼 통신)로 측정 보고를 보냅니다.
A1과 A2의 보고도 A0를 거쳐 이 연결로 들어옵니다. 그래서 Pi에서는 A0에 연결된 시리얼 포트를 읽도록 구성했습니다.
다음은 거리값을 얻는 과정입니다.
(쉼)

[가리킬 곳]
Pi와 A0 사이의 하늘색 USB 케이블

[화면 핵심어]
Pi / A0 / USB 시리얼

[근거]
firmware/fire_tag_anchor/fire_tag_anchor.ino:3, raspberrypi/fire_tag_receiver.py:246

## Slide 4

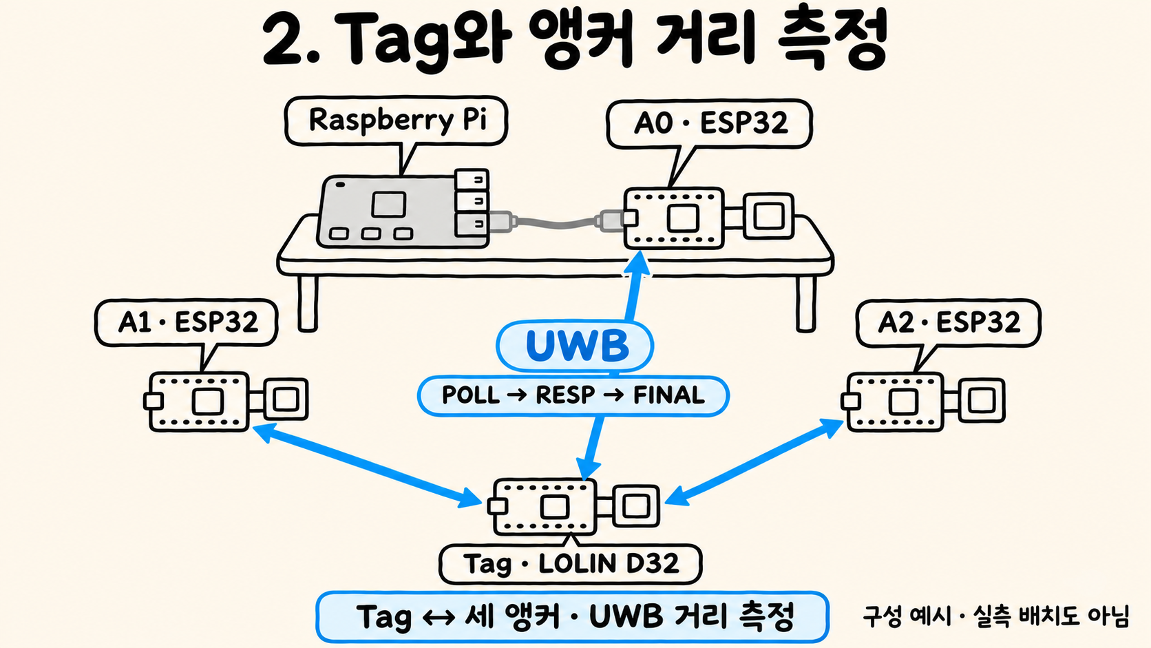
[picture p11: figure]

FIRE-TAG · 11/16

04 / 12

Notes: 슬라이드 4: Tag와 앵커 거리 측정
본편. 예상 35초 (추정, 리허설 전)

[발표 대본]
유선 연결에 앞서, 거리값은 여기서 만들어집니다.
Tag가 앵커에 요청을 보냅니다. 앵커가 응답하면 Tag가 마지막 메시지를 보냅니다.
그림의 POLL(폴), RESP(알이에스피), FINAL(파이널) 순서입니다. 앵커는 이 교환에서 얻은 시간 정보로 거리를 계산합니다.
Tag가 세 앵커와 이 과정을 반복합니다. 각 앵커까지의 거리값을 모아 다음 단계로 전달합니다.
(쉼)

[가리킬 곳]
Tag와 세 앵커 사이의 양방향 UWB 화살표

[화면 핵심어]
UWB / POLL / RESP / FINAL / 세 앵커 거리

[근거]
firmware/fire_tag_tag/fire_tag_tag.ino:3, firmware/fire_tag_anchor/fire_tag_anchor.ino:3

## Slide 5

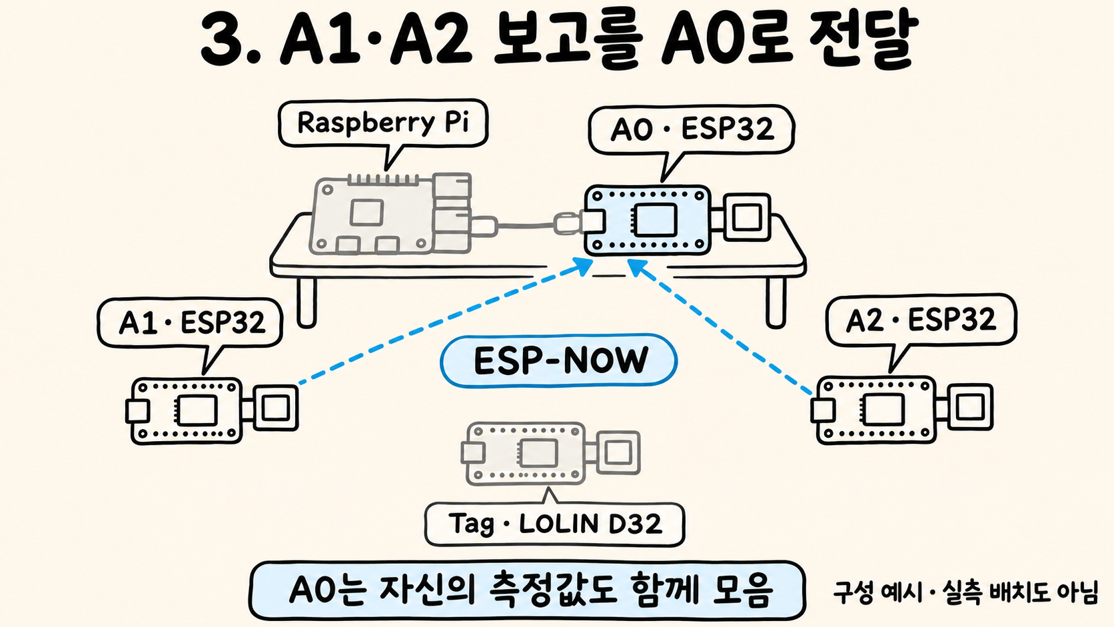
[picture p12: figure]

FIRE-TAG · 11/16

05 / 12

Notes: 슬라이드 5: A1·A2 보고를 A0로 전달
본편. 예상 35초 (추정, 리허설 전)

[발표 대본]
측정한 거리값은 A0에 모읍니다.
A1과 A2는 ESP-NOW(이에스피나우)로 A0에 측정 보고를 보냅니다. A0는 자신의 측정값도 함께 모읍니다.
여기서 UWB는 거리 측정에 쓰고, ESP-NOW는 앵커 사이의 보고 전달에 씁니다.
Pi가 ESP-NOW 보고를 직접 받는 구조는 아닙니다. Pi에는 A0가 USB로 전달합니다.
(쉼)

[가리킬 곳]
A1·A2에서 A0로 들어오는 점선 화살표

[화면 핵심어]
ESP-NOW / A1·A2 / A0 / USB 전달

[근거]
firmware/fire_tag_anchor/fire_tag_anchor.ino:3~7

## Slide 6

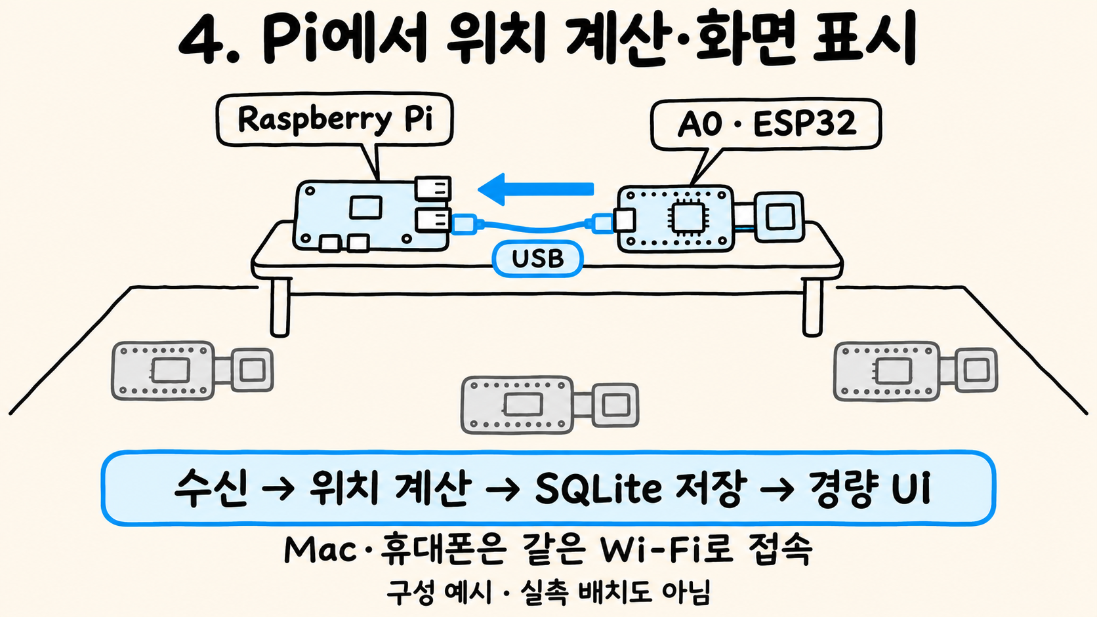
[picture p13: figure]

FIRE-TAG · 11/16

06 / 12

Notes: 슬라이드 6: Pi에서 위치 계산·화면 표시
본편. 예상 35초 (추정, 리허설 전)

[발표 대본]
A0가 보낸 보고를 Pi에서 처리합니다.
수신기는 교정된 앵커 좌표와 Tag 거리값으로 평면 위치를 계산합니다. 계산한 좌표는 SQLite(에스큐엘라이트) 데이터베이스에 저장합니다.
경량 웹 서버는 저장된 값을 읽어서 화면에 제공합니다. 같은 Wi-Fi(와이파이)의 Mac이나 휴대폰에서 Pi에 접속합니다.
다음 화면에서는 이 처리 중 계산과 저장 부분을 실제 코드로 보겠습니다.
(쉼)

[가리킬 곳]
USB 보고 방향과 하단 처리 순서

[화면 핵심어]
수신 / 위치 계산 / SQLite 저장 / 경량 UI / 같은 Wi-Fi

[근거]
raspberrypi/fire_tag_receiver.py:443, raspberrypi/fire_tag_web_lite.py:1

## Slide 7

거리값을 좌표로 계산해 저장

입력: 교정된 앵커 좌표와 Tag 거리(m)

result = solve_position(self.anchors, ranges)

if result is None:

좌표 계산

# ... 오류 로그 출력 생략

return

x · y

x, y, rms = result

# ... 상태 갱신·로그 생략

if self.store:

SQLite 저장

self.store.position(

tag, seq, x, y, rms, ranges, group["alert"])

최근 좌표 갱신

앞선 조건: 세 앵커 거리 수집 · 앵커 좌표 교정 완료

self: 수신기 / ranges: 거리(m) / tag·seq·group: 태그 ID·회차·수신 묶음

fire_tag_receiver.py · flush() 발췌 (검사·상태 갱신·로그 일부 생략)

FIRE-TAG · 11/16

07 / 12

Notes: 슬라이드 7: 거리값을 좌표로 계산해 저장
본편. 예상 45초 (추정, 리허설 전)

[발표 대본]
앞에서 설명한 계산과 저장을 담당하는 코드입니다.
먼저 위쪽의 solve_position(솔브 포지션)을 보시면, 앵커 좌표와 거리값을 넣어 위치를 구합니다. 계산할 수 없으면 여기서 처리를 멈춥니다.
계산이 끝나면 x, y(엑스, 와이) 좌표를 얻습니다. 아래의 store.position(스토어 포지션)이 결과를 데이터베이스에 저장합니다.
그 전에 세 앵커의 거리 수집과 교정 완료를 검사합니다. 화면에는 핵심 부분만 발췌했습니다.
(쉼)

[가리킬 곳]
solve_position 호출, 실패 시 return, self.store.position 호출

[화면 핵심어]
앵커 좌표 / ranges / solve_position / x·y / SQLite 저장

[근거]
raspberrypi/fire_tag_receiver.py:443~476, Store.position:114~119

## Slide 8

경량 화면에 저장 좌표를 표시

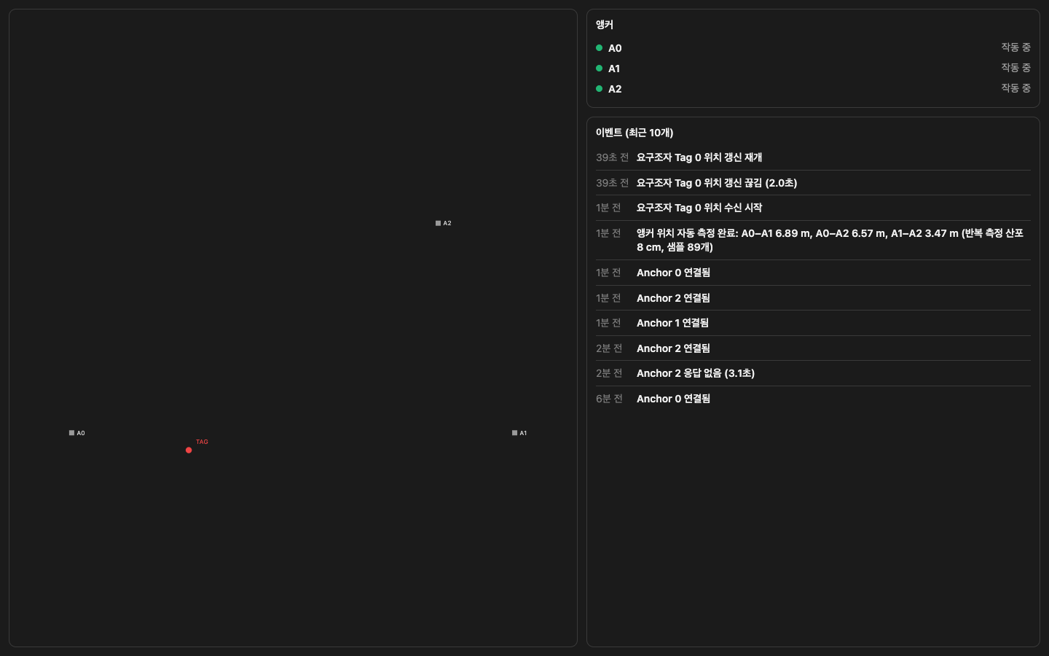
[picture p14: figure]

FIRE-TAG · 11/16

위치 점

앵커 상태

최근 이벤트
10개

ZIP 원본 UI 사용

08 / 12

Notes: 슬라이드 8: 경량 화면에 저장 좌표를 표시
본편. 예상 35초 (추정, 리허설 전)

[발표 대본]
이어서 실제 Pi에서 제공한 경량 화면입니다.
제공받은 ZIP의 경량 UI 원본을 적용했습니다. 화면에서는 Tag의 마지막 저장 위치를 점으로 보여줍니다.
오른쪽에서는 앵커 상태와 최근 이벤트 10개를 확인합니다. 새 좌표가 들어오면 위치 점이 갱신됩니다.
이번 발표는 이 경량 화면까지입니다. 이어서 실제 접속 영상을 보여드리겠습니다.
(쉼)

[가리킬 곳]
Tag 위치 점, 앵커 상태, 최근 이벤트

[화면 핵심어]
위치 점 / 앵커 상태 / 최근 이벤트 10개 / ZIP 원본 UI

[근거]
raspberrypi/web/index_lite.html:129, raspberrypi/fire_tag_web_lite.py:21, 이미지 저장/08_Pi_경량UI_실제화면.png

## Slide 9

실제 Pi에서 좌표 갱신을 확인

FIRE-TAG · 11/16

41.56초

실제 접속 녹화

새 좌표에 따라
위치 점 갱신

영상을 클릭해 재생

09 / 12

Notes: 슬라이드 9: 실제 Pi에서 좌표 갱신을 확인
본편. 예상 55초 (추정, 리허설 전)

[발표 대본]
실제 Pi에 접속해 녹화한 영상입니다.
위치 점이 갱신되는 모습을 보시겠습니다.

[영상 41.56초 재생. 재생 중에는 설명을 멈춥니다.]

(쉼)

[가리킬 곳]
영상 재생 후 Tag 점의 갱신

[화면 핵심어]
실제 Pi 접속 / 41.56초 / 새 좌표 갱신

[근거]
경량버전/Pi_경량UI_실제접속시험.mp4, 경량버전/11월16일_발표자료.md:4~5절

## Slide 10

통신·저장·화면 갱신을 확인

이번에 확인한 동작

다음 시험

세 앵커 거리 교정 완료

기준 위치와 오차 비교

Pi 수신·좌표 저장

사람·가림 조건 비교

경량 화면의 새 좌표 갱신

화재 현장 신뢰성 미검증

매 시험 전: 앵커 번호·고정 배치·세 쌍 거리 확인

앵커를 옮겼다면 재시작 후 재교정

FIRE-TAG · 11/16

10 / 12

Notes: 슬라이드 10: 통신·저장·화면 갱신을 확인
본편. 예상 35초 (추정, 리허설 전)

[발표 대본]
여기까지 이번에 확인한 결과입니다.
세 앵커의 거리값을 Pi로 전달하고, 계산한 좌표를 저장해 경량 화면에서 갱신하는 흐름을 확인했습니다.
시험할 때마다 앵커 번호와 고정 배치, 앵커 세 쌍의 거리를 확인해야 합니다. 앵커를 옮기면 다시 교정합니다.
실제 기준 위치와 비교한 오차나 사람에게 가려지는 조건은 추가 시험이 필요합니다. 화재 현장 신뢰성도 아직 검증하지 않았습니다.
(쉼)

[가리킬 곳]
이번 확인 결과와 남은 시험

[화면 핵심어]
세 앵커 교정 완료 / 새 좌표 갱신 / 배치·상호 거리 확인 / 정확도·가림 시험

[근거]
경량버전/11월16일_발표자료.md:4~5절

## Slide 11

시험 시작마다 앵커를 다시 교정

run_dev.sh 실행 시 교정 플래그 설정

config.update(

11/9 교정 거리

앵커 쌍 | 거리
A0–A1 | 6.89 m
A0–A2 | 6.57 m
A1–A2 | 3.47 m

auto_calibrate=True,

calibration_mode="anchor_ranges")

p.write_text(json.dumps(

config, ensure_ascii=False,

indent=2) + "\n", encoding="utf-8")

시험마다 번호·고정 배치·상호 거리 확인

config: 기존 설정 / p: 설정 파일 경로 · 일부 발췌

선택 부록

11 / 12

Notes: 슬라이드 11: 시험 시작마다 앵커를 다시 교정
선택 부록. 본편 시간에서 제외. 예상 40초 (추정, 리허설 전)

[발표 대본]
앵커 배치가 바뀌는 경우의 처리입니다.
실행 스크립트가 시작할 때마다 자동 교정 플래그를 켭니다. A0·A1·A2의 세 쌍 거리를 모아 좌표를 다시 정하도록 했습니다.
마지막 시험에서는 세 쌍의 교정을 완료했습니다. 실행 도중 앵커를 옮기면 다시 시작해 재교정해야 합니다.
(쉼)

[가리킬 곳]
config.update의 교정 플래그와 세 쌍 거리 표

[화면 핵심어]
auto_calibrate / anchor_ranges / A0–A1 / A0–A2 / A1–A2

[근거]
raspberrypi/run_dev.sh:28~37, raspberrypi/anchor_pair_calibration.py:37~67, 경량버전/11월16일_발표자료.md:5절

## Slide 12

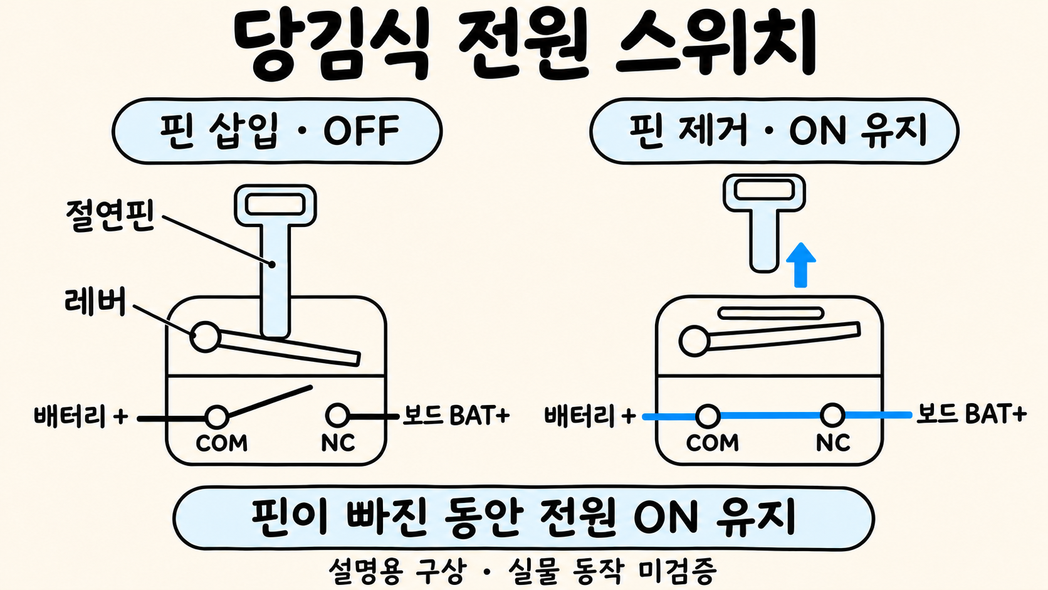
[picture p15: figure]

선택 부록

12 / 12

Notes: 슬라이드 12: 당김식 전원 스위치 구상
선택 부록. 본편 시간에서 제외. 예상 30초 (추정, 리허설 전)

[발표 대본]
이 부분은 추가 제작 구상입니다.
절연핀이 레버를 누를 때는 COM–NC(콤, 엔씨) 접점이 열려 배터리 전원이 꺼집니다. 핀을 빼면 레버가 복귀하고 접점이 연결돼 켜진 상태를 유지합니다.
실물 제작과 동작 시험은 아직 하지 않았습니다. 이번 경량 UI 구현 결과와는 구분합니다.
(쉼)

[가리킬 곳]
왼쪽 핀 삽입 OFF, 오른쪽 핀 제거 ON

[화면 핵심어]
핀 삽입 OFF / 핀 제거 ON 유지 / 실물 동작 미검증

[근거]
트리거_구상/BATTERY_PULL_TRIGGER.md
