Ksyear/FIRE-TAG/발표자료/11/16/이미지 저장/원래버전/06_당김식_배터리트리거_구상.png

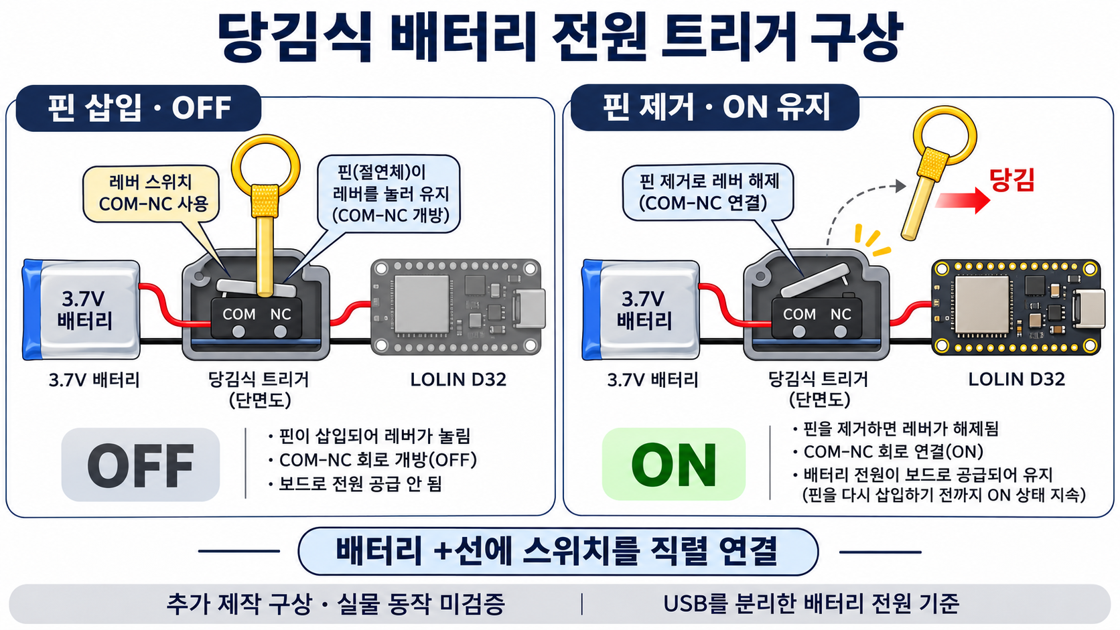
발표자료/11/16/이미지 저장/원래버전/06_당김식_배터리트리거_구상.png
