Ksyear/FIRE-TAG/발표자료/11/16/트리거_구상/images/스위치_트리거_구상도.png

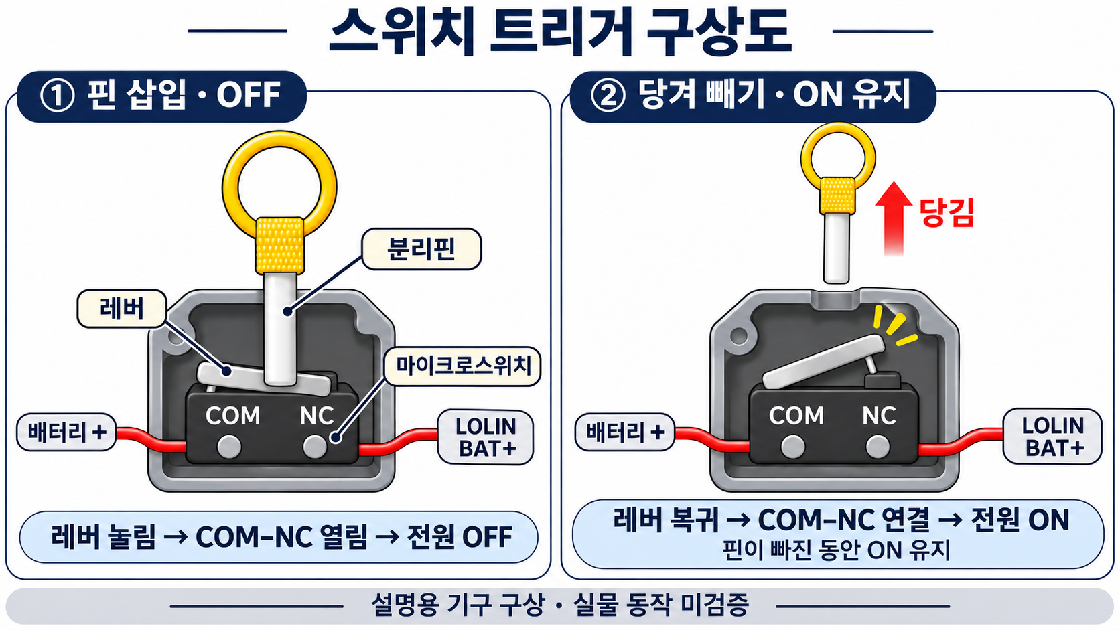
발표자료/11/16/트리거_구상/images/스위치_트리거_구상도.png
