Ksyear/FIRE-TAG/(commit log)

2026-10-05 docs: 발표용 최소 부품표와 DWM3000EVB SPI 연결 시험 결과 추가
    - FIRE-TAG_피요구조자_발표용_최소부품.md: Anchor 3 + 요구조자 Tag 1 구성의 구매 목록
    (DWM3000EVB x4, ESP32 DevKitC x3, LOLIN D32 x1, LiPo, 케이블, 충전기)
    - FIRE-TAG_SPI_Test_Package/: 보드 4개에서 DWM3000 DEV_ID 0xDECA0302 읽기 40/40 통과,
    배선도, 시험 스케치, 원본 시리얼 로그, 업로드 시 관찰된 문제(기본 속도 실패 →
    38400 --no-stub) 기록
    - .gitignore: macOS 메타데이터, Python 캐시, Pi 런타임 데이터(DB·기록) 제외
    이후 통신 코드 PR의 기준 커밋이다.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
2026-10-05 build(firmware): DW3000 드라이버를 git 서브모듈로 고정
    Makerfabs-ESP32-UWB-DW3000 저장소(커밋 9d449b8)를 firmware/third_party/에 서브모듈로 둔다.
    그 안의 Dw3000/ 폴더는 Qorvo DW3000 API를 NConcepts가 Arduino로 포팅한 것이다.
    복사본을 넣지 않고 참조만 하는 이유: library.json은 Apache-2.0이라고 하지만 소스 헤더는
    'Decawave Ltd, All rights reserved'로 되어 있어, 공개 저장소에 재배포해도 되는지 불분명하다.
2026-10-05 feat(firmware): Tag·Anchor 공통 UWB 라이브러리 FireTagUwb
    Tag와 Anchor가 반드시 같은 값을 써야 하는 것을 한 곳에 모은다. 값이 어긋나면
    오류 없이 통신만 안 되기 때문이다.
    - 핀(SCK18 MISO19 MOSI23 CS27 RST26 IRQ34): SPI 시험으로 4개 보드에서 확인한 배선
    - UWB 설정: 채널 9(국내 UWB 대역 기존·신규 기준 모두 포함), PLEN128, 6.8 Mbps
    - DS-TWR 타이밍: 예약 응답 2000 uus, 수신 창 1500 + 1200 uus (ESP32 SPI 처리 여유)
    - IEEE 802.15.4 프레임 형식: POLL / RESP(경보 비트) / FINAL(타임스탬프 3개 + 수신 확인)
    - ESP-NOW Report(29 B)와 Pi 명령 Command(8 B) 구조체
    - 시리얼 속도 SERI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
2026-10-05 feat(firmware): 요구조자 Tag — DS-TWR 개시자와 경보 LED
    LOLIN D32용. 100 ms마다 Anchor 0 → 1 → 2 순서로 POLL/RESP/FINAL을 수행한다.
    거리는 앵커가 계산하므로 Tag는 Wi-Fi를 쓰지 않는다.
    - RESP의 경보 비트를 사이클 단위로 반영한다(응답한 앵커가 하나라도 켜면 켬, 아무도
    응답하지 않으면 유지). 내장 LED(IO5, LOW = 켜짐)를 0.25초 간격으로 깜빡인다.
    - FINAL에 실제로 적용한 경보 상태를 실어 Pi가 전달 여부를 확인할 수 있게 한다.
    - 1초마다 앵커별 성공 수와 마지막 실패 원인(NO_RESP, LATE 등)을 시리얼로 요약한다.
    실기 확인: Anchor 0과 거리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
2026-10-05 feat(firmware): Anchor — DS-TWR 응답자, ESP-NOW 중계, Pi 명령 처리
    ESP32 DevKitC용. ANCHOR_ID 하나로 세 앵커를 만든다.
    - 응답자: FINAL을 받으면 비대칭 DS-TWR로 거리를 계산한다(32비트 차이로 카운터 넘김 처리).
    - ANCHOR_ID 0(게이트웨이): 자기 거리와 ESP-NOW로 받은 Anchor 1·2의 거리·상태·ACK를
    USB에 JSON 한 줄씩 출력한다. Pi의 'CMD <id> <target> <name> <arg>' 줄을 받아 실행하고
    나머지 앵커로 전달한다.
    - ANCHOR_ID 1, 2: 결과를 ESP-NOW 브로드캐스트로 보내고, 받은 명령을 실행한 뒤 ACK를 보낸다.
    - 명령: ping, reboot(ACK를 보낸 뒤 300 ms 후 재시작), alert(태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
    [fire_tag_anchor.ino]
2026-10-05 build(firmware): arduino-cli 빌드·업로드 스크립트
    ./build.sh tag | anchor <0-2> [포트] 로 컴파일과 업로드를 한다. Arduino IDE에 들어 있는
    arduino-cli를 쓰고, 라이브러리는 저장소 안의 것만 쓴다(~/Documents/Arduino를 건드리지 않음).
    - Apple Silicon에서 기본 ctags가 실행되지 않는 문제 때문에 arm64 ctags 경로를 지정한다.
    - SAFE_UPLOAD=1: esptool 38400 baud + --no-stub. SPI 시험과 오늘 업로드에서 일반 속도가
    실패한 보드도 이 방식으로는 기록·해시 검증을 통과했다.
2026-10-05 feat(pi): 수신기 — 다변측량, SQLite 저장, 명령 큐와 경보 동기화
    Anchor 0의 USB 시리얼을 혼자 소유하는 프로세스다.
    - 같은 tag·cycle 번호의 거리 3개를 묶고(uint16 넘김 처리, 1사이클 순서 뒤바뀜 허용),
    앵커·Tag 높이 차이를 빼서 바닥 평면 거리로 바꾼 뒤 선형 초기값 + Gauss-Newton으로 푼다.
    - 위치, 앵커 상태, 이벤트를 SQLite(WAL)에 0.5초 단위로 묶어 기록한다.
    - 웹 서버가 DB에 넣은 명령을 'CMD' 줄로 보내고, ACK가 모자라면 1초 간격으로 재전송한다
    (ping 3회, reboot는 재전송하지 않음).
    - 경보는 원하는 상태만 DB에 두고, 앵커 상태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
    [fire_tag_receiver.py]
2026-10-05 feat(pi): 대시보드 웹 서버와 오프라인 화면
    표준 라이브러리만 쓰는 웹 서버와 외부 파일 없는 단일 HTML이다. Pi 핫스팟에는
    인터넷이 없어서 CDN 글꼴이나 라이브러리를 쓰면 화면이 뜨지 않기 때문이다.
    - GET /api/state: 앵커, 위치, 30초 경로(시간 공백에서 끊음), 이벤트, 명령 결과
    - POST /api/command (ping, reboot), POST /api/alert (경보 켜기/끄기): DB에만 넣고
    실제 전송은 수신기가 맡는다. 잘못된 입력은 400으로 거부한다.
    - GET /api/positions.csv: 엑셀용 BOM 포함 CSV
    - 화면: 평면도(앵커, 거리 원, 경로, 위치), 요구조자 카드와 끊김 원인, 경보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
    [fire_tag_web.py]
2026-10-05 feat(pi): Ubuntu Server 설치·핫스팟 스크립트
    Raspberry Pi 4 + Ubuntu Server 기준.
    - setup_pi.sh: python3-serial, network-manager, dnsmasq-base 설치, 수신기·웹 서버 systemd
    서비스 등록(웹은 CAP_NET_BIND_SERVICE로 일반 사용자가 80번 포트 사용). 인터넷이 있을 때 1회.
    - setup_hotspot.sh: netplan의 wifis.mode: ap는 NetworkManager 렌더러에서만 지원되므로 wlan0만
    NetworkManager로 넘기는 /etc/netplan/90-fire-tag-ap.yaml을 만든다. AP 모드는 NM shared
    모드가 되어 휴대폰에 DHCP를 주고 Pi는 10.42.0.1이 된다(netplan 소스 확인). 2.4 GHz 채널 11로
    앵커 ESP-NOW(채널 1)와 나눈다. 다른 netplan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
2026-10-05 docs: README와 시스템 구조 문서
    - README: 클론(서브모듈), 빌드·업로드(안전 모드), Pi 설치·핫스팟, 데이터 형식, 검증 범위와
    남은 위험, 오늘 실측 결과
    - docs/ARCHITECTURE.md: 전체 구성, 구성 단계(단독 시험 / 교실 시연 / 공장 화재), 시퀀스
    다이어그램(거리측정, 명령·경보), 상태 그래프(요구조자, 경보, 앵커 펌웨어), 클래스
    다이어그램(Pi, 펌웨어), 화면 구성, 실기 기록, 결정이 필요한 항목
    - 공장 화재 구성은 명시만 한다: 건물 안은 FIRE-TAG가, 건물 밖은 이동기지국 또는 상용 LTE가
    맡는 2단 구조. 근거(행정안전부, ITU-R P.1238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
2026-10-05 style: 명령 결과와 경보 확인을 기호 대신 글자로 표시
    대시보드와 이벤트 기록의 체크 기호를 글자로 바꾼다.
    - 점검 결과: 'A0✓ A1✓ A2✓' → 'A0 성공, A1 성공, A2 성공'
    - 경보 확인: '✓ Tag가 경보를 받았습니다' → 'Tag가 경보를 받았습니다'
    - docs/images의 화면 캡처를 바뀐 화면으로 다시 찍음
    표시 문구만 바뀌고 동작은 같다.
2026-10-05 docs: Tag–Anchor 0 실기 통신 기록 추가, 상태 표를 글자로 정리
    요구조자 Tag(LOLIN D32)와 Anchor 0(DevKitC)을 Mac에 연결하고 두 시리얼을 동시에 30초
    기록한 원본 로그와 캡처를 docs/evidence/2026-10-05_tag-anchor0/에 둔다.
    - 거리측정: 292회(초당 10회), 깨진 줄 0, 사이클 누락 0, 평균 234 mm·표준편차 29 mm(보정 전)
    - 경보 명령: Mac → Anchor 0 ACK → Tag 회신(FINAL의 tag_alert)까지 켜기·끄기 모두 148 ms
    - 확인하지 않은 것: 위치(x, y)는 앵커 3대가 필요해 이 기록의 범위가 아님, 실제 거리 대비 오차
    README와 ARCHITECTURE의 상태 표를 기호 대신 '확인 / 시뮬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
2026-10-05 docs: 시리얼 깨짐 기록 정정
    앞서 'Mac 허브 경로에서 116줄 중 1줄이 깨졌다(약 0.9%)'고 적었으나, 그 줄은 12초 기록이
    끝나는 순간 중간에 잘린 마지막 줄이었다. 전송 오류가 아니므로 정정한다.
    - 정상 동작 중 기록(12초, 30초)에서는 깨진 줄이 없었다.
    - 실제로 관찰된 것은 일반 속도 업로드 실패와, 그 직후 리셋해서 읽은 부팅 로그의 바이트 유실·
    조각 반복이다. 원인은 아직 모른다.
    - CRC-16 제안은 이에 맞춰 '예방 차원'으로 근거를 고쳤다.
2026-10-05 docs: 요구조자 Tag ↔ Anchor UWB 연결 패키지 추가
    SPI 시험 패키지와 같은 형식으로, Tag와 Anchor 연결에 필요한 것을 한 폴더에 모은다.
    FIRE-TAG_Tag_Anchor_UWB_Package/
    - FIRE-TAG_Tag_Anchor_UWB_Report.md: 구성·배선, 무선 설정, DS-TWR 방식과 계산식(APS013),
    프레임 형식과 타이밍, 명령·경보 경로, 빌드·업로드, 재현 방법, 실기 기록 01·02, 관찰된 문제,
    다음 단계, 근거 자료
    - firmware/: Tag·Anchor 소스와 FireTagUwb 스냅샷(최상위 firmware/와 동일, 단독 빌드 확인),
    precompiled/에 tag·anchor0·anchor1·anchor2 사전 빌드 펌웨어와 SHA-256
    - tools/capture_serial.py: 두 시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
2026-10-05 feat(pi): pyserial 없이도 시리얼을 읽도록 표준 라이브러리 경로 추가
    Pi에 python3-serial을 설치하려면 sudo 비밀번호가 필요하다. pyserial이 없으면 termios로
    포트를 직접 열어(115200, raw, DTR/RTS 내림) 같은 방식으로 읽고 쓴다. 장치가 빠지면
    OSError로 끝나서 재시작 스크립트가 다시 띄울 수 있다.
    pyserial이 없는 Mac에서 Tag 포트로 읽기를 확인했다.
2026-10-05 feat(pi): 앵커 위치를 Tag 거리로 자동 측정
    앵커 사이 거리를 줄자로 재지 않아도 되도록, Tag가 움직이는 동안 모은 거리(A0, A1, A2)만으로
    앵커 삼각형을 구한다.
    - anchor_calibration.py: 삼각부등식으로 초기값을 잡고, Tag 위치와 앵커 위치를 번갈아
    최소제곱으로 푼다. A0 = (0, 0), A1은 +x축, A2는 위쪽으로 좌표를 고정한다.
    - 출발점 13개로 풀어 오차가 비슷한데 배치가 10 cm 넘게 다른 해가 있으면 '하나로 정해지지
    않음'으로 보고 적용하지 않는다(Tag를 한 줄로만 움직였거나 거의 안 움직인 경우).
    - 수신기: config의 auto_calibrate가 true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
2026-10-05 feat(pi): 시험용 실행 스크립트와 Pi 한 줄 설치
    - run_dev.sh: sudo나 systemd 없이 수신기와 대시보드(포트 8080)를 띄우고 접속 주소를
    출력한다. 원본 기록(data/raw.jsonl)을 남긴다. stop, status 지원.
    - bootstrap.sh: Pi에서 curl 한 줄로 이 브랜치의 raspberrypi/를 ~/fire-tag에 받아 시리얼 권한,
    Anchor 0 연결을 확인하고 run_dev.sh로 시작한다. git, pip, sudo가 필요 없다. 다시 실행하면
    갱신하되, 측정된 앵커 좌표(config.json)와 data/는 유지한다.
    run_dev.sh는 Mac에서 같은 Wi-Fi 주소로 접속(200)까지 확인했다.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
2026-10-05 Add direct anchor ranging and fix Pi receiver startup and DB locking
    [anchor_pair_calibration.py, fire_tag_anchor.ino, fire_tag_receiver.py]
2026-11-09 Document pull-pin battery power wiring and DeviceMart parts
2026-11-09 Add generated indoor setup image and PowerPoint placement guide
2026-11-09 Add step-by-step communication images and pull-pin trigger concept
2026-11-09 Add close-up pull-pin switch trigger concept image
2026-11-09 Move trigger concepts into November 16 presentation materials
2026-11-09 Exclude transient PowerPoint lock files
2026-11-09 Add battery wiring, connector parts and validation plans to presentation
